uvmaero/CleanSpeed_6.0_Board/Documentation/Working in the packs.pdf

## Standard Operating Procedure TEMPLATE

This template is to be adapted to particular processes for individual labs. A specific SOP may need more sections than what is listed below. Once completed, a copy should be kept in the lab safety notebook with documentation that researchers have reviewed and will comply with the completed document.

Laboratory Supervisor (PI): | Date: 10/13/23
Building: Votey | Room(s): 118

## Section 1: Process and Composition

Basic explanation of the process (e.g. work with HF, working in a glove box, etc.) AND composition of the solution (e.g. aqua regia, piranha solution, etc.) Work with High Voltage, Working with accumulators off the Car

## Section 2: Potential Hazards

Describe the hazards and how they can harm researchers. High voltage, Shock and arch flash

## Section 3: Engineering Controls

Describe where the work will be done in the lab. e.g. fume hood, glove box, biosafety cabinet, specific lab bench, etc. On an isolated work bench

## Section 4: Special Handling Procedures

Describe any particular handling procedures that should be followed. Removal of all jewlery Not wearing any thing dangling ie hoodie strings rolled up sleeves

## Section 5: Personal Protective Equipment (PPE)

Describe the PPE that should be worn, including the material, thickness, and other particulars. High Voltage Gloves (leather protectors, isolation layer, cloth), Arch face sheild,

## Section 6: Storage Requirements

Describe any requirements based on the process or solution(s) being used. Include primary and secondary containers, cabinets, etc. The batteries must be stored in fire proof container (typically withing the accumulator boxes) When work is complete they must be stored such that a tool is needed to open gain access to the high voltage. If storage under tool is not possible the area must be well labeled that high voltage is pressent and no exposed high voltage may be pressent. the use of high voltage blankets may be required.

## Section 7: Spill and Accident Procedures

First Aid measures:
Inhalation:
Ingestion:
Skin absorption:
Eye exposure:
Chemical (or Biological or Radioactive) Spill measures:

## Section 8: Waste Disposal

Describe how to handle and dispose of waste generated during the process or simply the solution. Include labeling for storage of waste and tagging for waste pick up. Waste will only be produced when a cell has gone bad. To dispose of the cell it must be discharged to 2.5V via a resistor bank then work with the lab suporvisor as to the propper disposal for the volume of cells.

## Section 9: Decontamination

If decontamination will be needed (of glassware, work area, etc.), detail what will be used to perform the decontamination and the process of completing this task.

## Section 10: Training

All personnel are required to complete the general online and classroom safety training courses. Any personnel must review the guidelines here before work commences. Any appropriate Lab Risk Assessments or Chemical Use and Planning Forms must be reviewed as well.
If there are particular training requirements for the lab, include them here. In Person High voltage AERO training: Training includes: 1) A lesson in the dangers of high voltage 2) Learning how to propperly Don all PPE 3) Dexterity training and testing away from high voltage to get used to the PPE 4) Simulating the high Voltage work at smaller scale 5) Demonstraiting knowledge of high voltage and the previous procedures 6) Doinng monitored high voltage work

## Section 11: Specific Procedure Description

In DETAIL, describe the procedure for either doing the work or making the solution mentioned in Section 1. Specific amounts of reagents should be included where appropriate. This can be a step-by-step guide. 1) Have the accumulator(s) placed on the green high voltage cart 2) Ensure someone is in charge of the "pokey stick" who will monitor all high voltage work 4) Have the RSO check the area is secure and there is proper egress 5) Turn the SMD to the "off" position and have the RSO or a leader fill out the "Lock Out Tag Out" form. 6) Once deemed "safe" and locked out, the container can be opened using non-isolated tools 7) Once the pack is open, high voltage PPE must be donned and whatever work that needs to be done on the packs can be carried out using isolated tools. 8) Once work is complete, the packs must be secured using a tool (e.g. bolted down) so the packs are safe. 9) If unable to close the packs, they must be covered with high voltage blankets and whoever is doing the work must provide contact information as well as the RSO information and signage indicating high voltage is present 10) Unless the packs are going to be placed on the car, the SMD shall remain locked until they go into service.

## Section 12: “What-If” Analysis

In DETAIL, examine any foreseeable incidents to help prevent accidents and injuries from occurring. Fire: small fire: If possible and safe isolate the cell from the packs and place it within a lipo pouch. Once in the lipo pouch place the pouch outside on the concrete slab to the left of the doors across from the shop. Report the incident to the RSO and the lab supervisor. large fire: If there is a fire within the accumulator that cannot be mitigated safley there are a few options for action. If the fire is small but cannot be removed from accumulator, safely move the accumulator out of the building on the High Voltage cart. Contact the RSO, lab supervisor and uvm police. If the fire is not safe to be around, evacuate the club space and votey. The quickest way to do this is via any of the pull fire alarms. Contact 911 and inform the lab suporvisor. Remain near votey so that you can be the point of contact for the first responders who arrive.

## Section 13: Signature(s) of Compliance

I have read and fully understand the above SOP. I will adhere to all stated regulations and safety measures when using this chemical. Colin Grund

__________________________________ | _______________________________________
Name (Print) | Signature and Date
__________________________________ | _______________________________________
Name (Print) | Signature and Date
__________________________________ | _______________________________________
Name (Print) | Signature and Date
__________________________________ | _______________________________________
Name (Print) | Signature and Date
__________________________________ | _______________________________________
Name (Print) | Signature and Date
__________________________________ | _______________________________________
Name (Print) | Signature and Date
__________________________________ | _______________________________________
Name (Print) | Signature and Date
__________________________________ | _______________________________________
Name (Print) | Signature and Date
__________________________________ | _______________________________________
Name (Print) | Signature and Date
__________________________________ | _______________________________________
Name (Print) | Signature and Date
