uvmaero/CleanSpeed_6.0_Board/Big Daddy/bom/2024-02-14T124227.xlsx

Index | Quantity | Part Number | Manufacturer Part Number | Description | Customer Reference | Available | Backorder | Unit Price | Extended Price USD
1 | 4 | 20J15KE-ND | 20J15KE | RES 15K OHM 5% 10W AXIAL |  | 4 | 0 | 3.99 | 15.96
2 | 10 | RMCF2512FT1R00CT-ND | RMCF2512FT1R00 | RES 1 OHM 1% 1W 2512 |  | 10 | 0 | 0.148 | 1.48
3 | 5 | 160-1367-5-ND | LTV-817S | OPTOISOLATR 5KV TRANSISTOR 4-SMD |  | 5 | 0 | 0.44 | 2.20
4 | 5 | PPC39KW-1CT-ND | PR01000103902JR500 | RES 39K OHM 1W 5% AXIAL |  | 5 | 0 | 0.27 | 1.35
5 | 5 | 408-1947-1-ND | HRG3216P-1000-B-T1 | RES SMD 100 OHM 0.1% 1W 1206 |  | 5 | 0 | 1.18 | 5.90
6 | 5 | RL12S.20FCT-ND | RL1220S-R20-F | RES 0.2 OHM 1% 1/3W 0805 |  | 5 | 0 | 0.3 | 1.50
7 | 10 | 4878-1N4148WCT-ND | 1N4148W | DIODE GEN PURP 75V 150MA SOD123F |  | 10 | 0 | 0.07 | 0.70
8 | 10 | 1801-SS16CT-ND | SS16 | DIODE SCHOTTKY 60V 1A DO214AC |  | 10 | 0 | 0.252 | 2.52
9 | 10 | DESD2CAN2SOQ-7DICT-ND | DESD2CAN2SOQ-7 | TVS DIODE 24VWM 41VC SOT23 |  | 10 | 0 | 0.336 | 3.36
10 | 10 | 1801-TS4148RCGCT-ND | TS4148 RCG | DIODE GEN PURP 75V 100MA 0603 |  | 10 | 0 | 0.137 | 1.37
11 | 10 | 160-1367-5-ND | LTV-817S | OPTOISOLATR 5KV TRANSISTOR 4-SMD |  | 10 | 0 | 0.269 | 2.69
12 | 10 | 296-46427-1-ND | LM5050MKX-1/NOPB | IC OR CTRLR N+1 6SOT |  | 10 | 0 | 1.847 | 18.47
13 | 2 | LT1528CQ#PBF-ND | LT1528CQ#PBF | IC REG LIN POS ADJ 3A 5DDPAK |  | 2 | 0 | 11.61 | 23.22
14 | 5 | ICM7555ISA+-ND | ICM7555ISA+ | IC OSC SGL TIMER 500KHZ 8-SOIC |  | 5 | 0 | 4.12 | 20.60
15 | 5 | 2521-IS31LT3360-SDLS3-TRCT-ND | IS31LT3360-SDLS3-TR | IC LED DRV RGLTR PWM SOT89-5 |  | 5 | 0 | 0.87 | 4.35
16 | 5 | TLP184(BL-TPLSECT-ND | TLP184(BL-TPL,SE | OPTOISO 3.75KV TRANS 6-SO 4 LEAD |  | 5 | 0 | 0.5 | 2.50
17 | 5 | LM317D2TR4GOSCT-ND | LM317D2TR4G | IC REG LIN POS ADJ 1.5A D2PAK-3 |  | 5 | 0 | 0.83 | 4.15
18 | 5 | Z768-ND | G5V-2-DC12 | RELAY GEN PURPOSE DPDT 2A 12V |  | 5 | 0 | 3.21 | 16.05
19 | 4 | IXFH34N65X2-ND | IXFH34N65X2 | MOSFET N-CH 650V 34A TO247 |  | 4 | 0 | 8.16 | 32.64
20 | 2 | PB2352-ND | T9VV1K15-12S | RELAY GEN PURPOSE SPST 40A 12V |  | 2 | 0 | 7.73 | 15.46
21 | 3 | 2449-J107F1CS123VDC.36-ND | J107F1CS123VDC.36 | RELAY GEN PURPOSE SPDT 12A 3V |  | 3 | 0 | 1.04 | 3.12
22 | 2 | Z2204-ND | G5V-1-DC3 | RELAY GENERAL PURPOSE SPDT 1A 3V |  | 2 | 0 | 2.22 | 4.44
23 | 5 | 2N7002NCT-ND | 2N7002 | MOSFET N-CH 60V 115MA SOT-23 | 5 | 5 | 0 | 0.45 | 2.25
24 | 5 | BCP53T1GOSCT-ND | BCP53T1G | TRANS PNP 80V 1.5A SOT223 |  | 5 | 0 | 0.4 | 2.00
25 | 5 | MMBT2222LT1GOSCT-ND | MMBT2222LT1G | TRANS NPN 30V 0.6A SOT23-3 |  | 5 | 0 | 0.15 | 0.75
