uvmaero/CleanSpeed_6.0_Board/BMS1/Jumper/production/Jumper_2024-02-16_11-31-33/bom.csv

Designator | Footprint | Quantity | Value | LCSC Part #
Jumper | LTC6812 | 1 | LTC6812
U2 | QFP-64_11x11_Pitch0.5mm | 1 | LTC6812-1
