uvmaero/CleanSpeed_6.0_Board/Documentation/connectors.xlsx

Index | Quantity | Part Number | Manufacturer Part Number | Description | Customer Reference | Available | Backorder | Unit Price | Extended Price USD
1 | 2 | 1873-2108-12S-ND | 2108-12S | CONFORMAL COATING ACRYLIC |  | 2 | 0 | 30.5 | 61.00
2 | 3 | 965-SLPPA25BSB1-ND | SLPPA25BSB1 | SURLOK PLUS |  | 3 | 0 | 12.11 | 36.33
3 | 3 | 965-SLPPA25BSR0-ND | SLPPA25BSR0 | SURLOK PLUS |  | 3 | 0 | 13.23 | 39.69
4 | 4 | 965-SLPIRABPSR0-ND | SLPIRABPSR0 | SURLOK PLUS |  | 4 | 0 | 11.11 | 44.44
5 | 4 | 965-SLPIRABPSB1-ND | SLPIRABPSB1 | SURLOK PLUS |  | 4 | 0 | 11.11 | 44.44
6 | 2 | 965-SLPIPA25BSB1-ND | SLPIPA25BSB1 | SURLOK PLUS, STRAIGHT PLUG, 5.7M | 2 | 2 | 0 | 14.42 | 28.84
7 | 2 | 965-SLPIPA25BSR0-ND | SLPIPA25BSR0 | SURLOK PLUS, STRAIGHT PLUG, 5.7M |  | 2 | 0 | 14.42 | 28.84
