uvmaero/CleanSpeed_6.0_Board/BMS1/Jumper/slpirabpsr4-c3d.STP

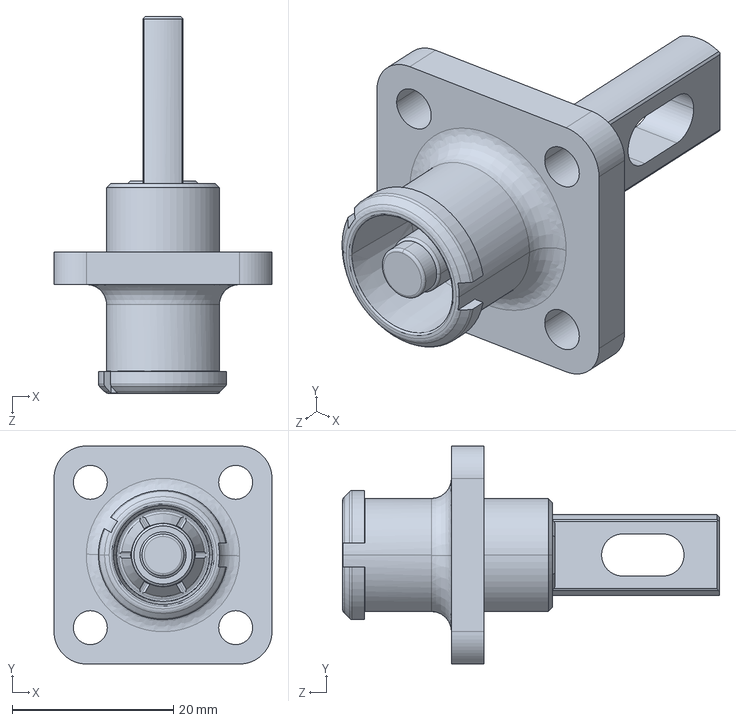
[picture p8: CAD file, 2024-05-02]
BMS1/Jumper/slpirabpsr4-c3d.STP
27.0 x 27.0 x 46.7 mm
