uvmaero/CleanSpeed_6.0_Board/BMS1/Print Schematic.pdf

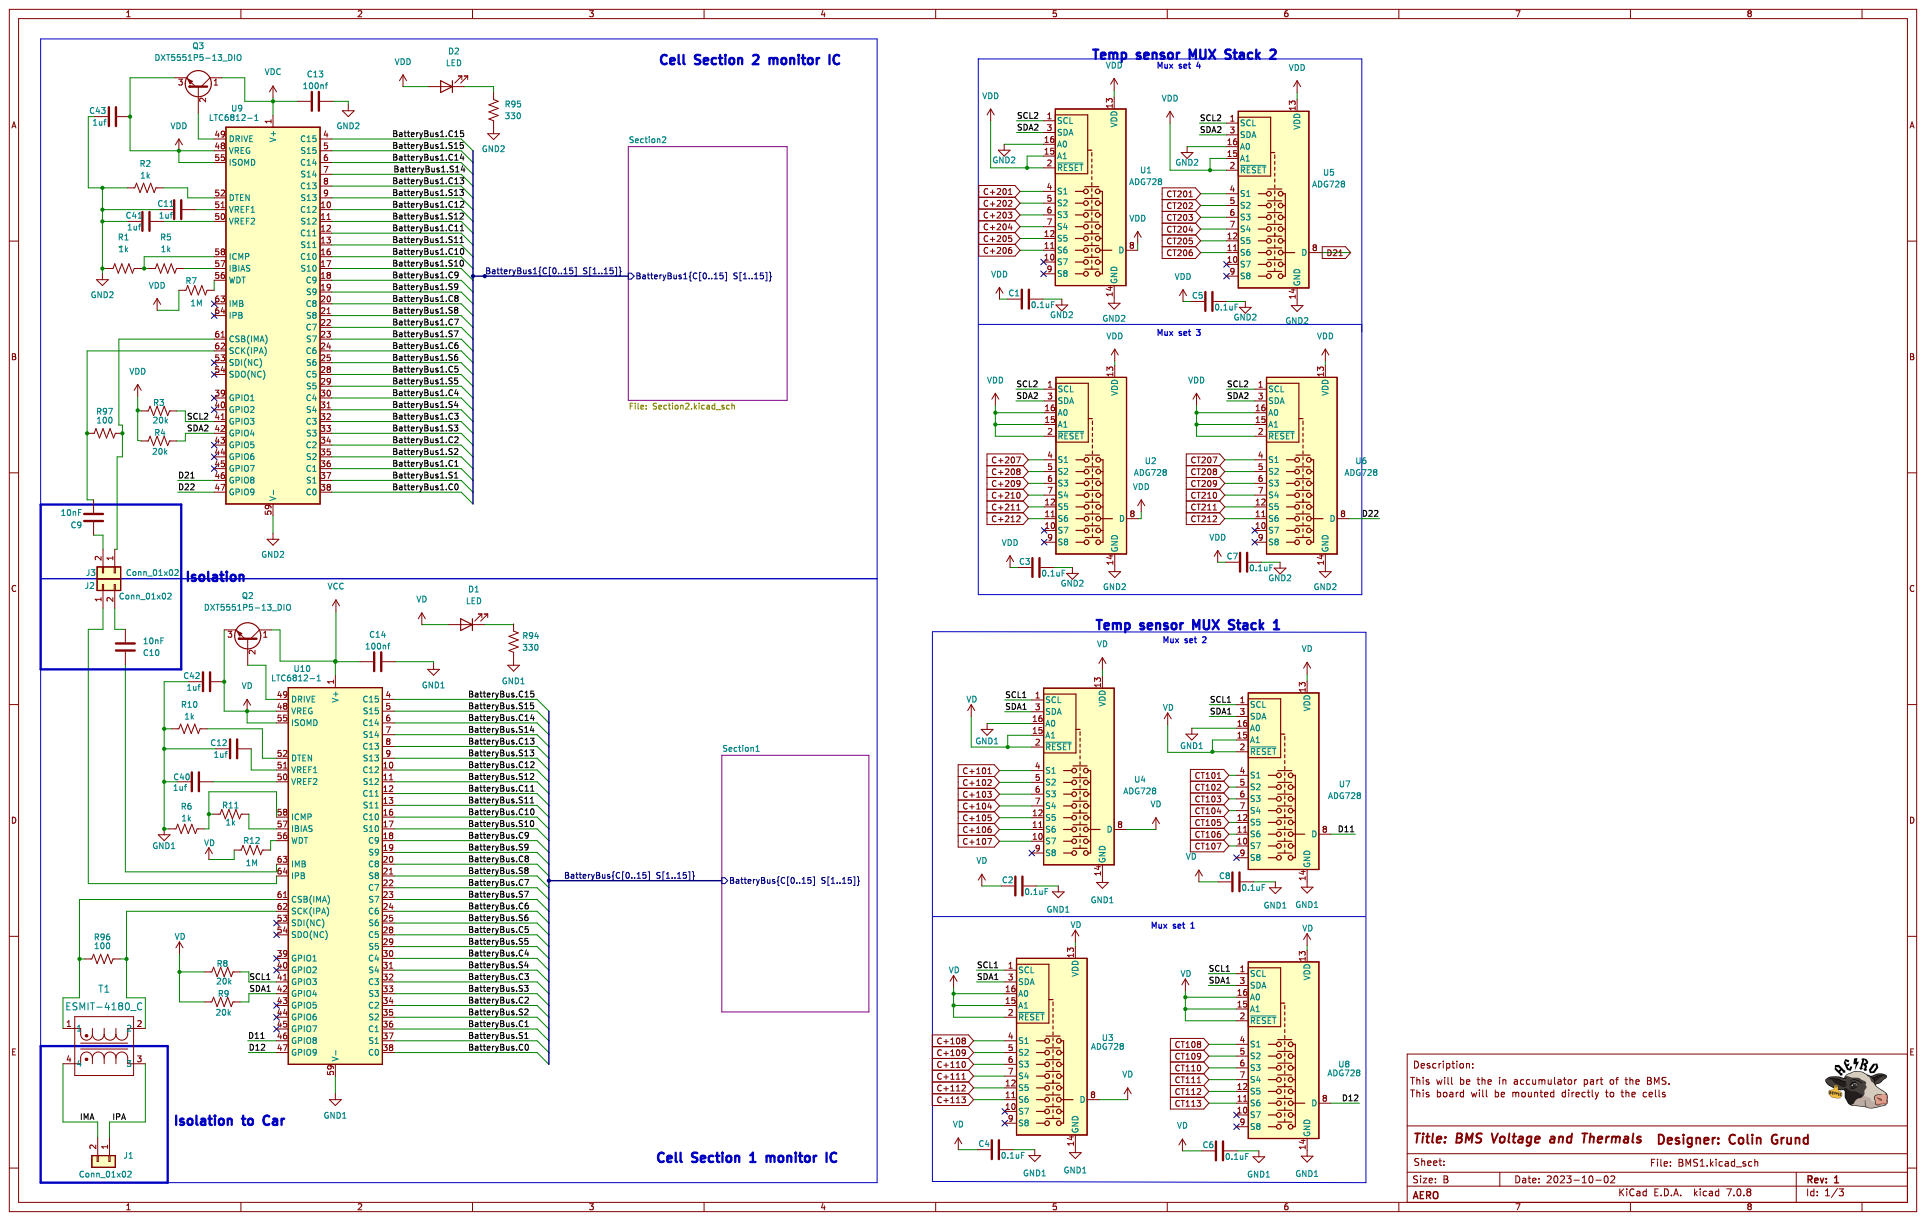
[picture p10: page 1]

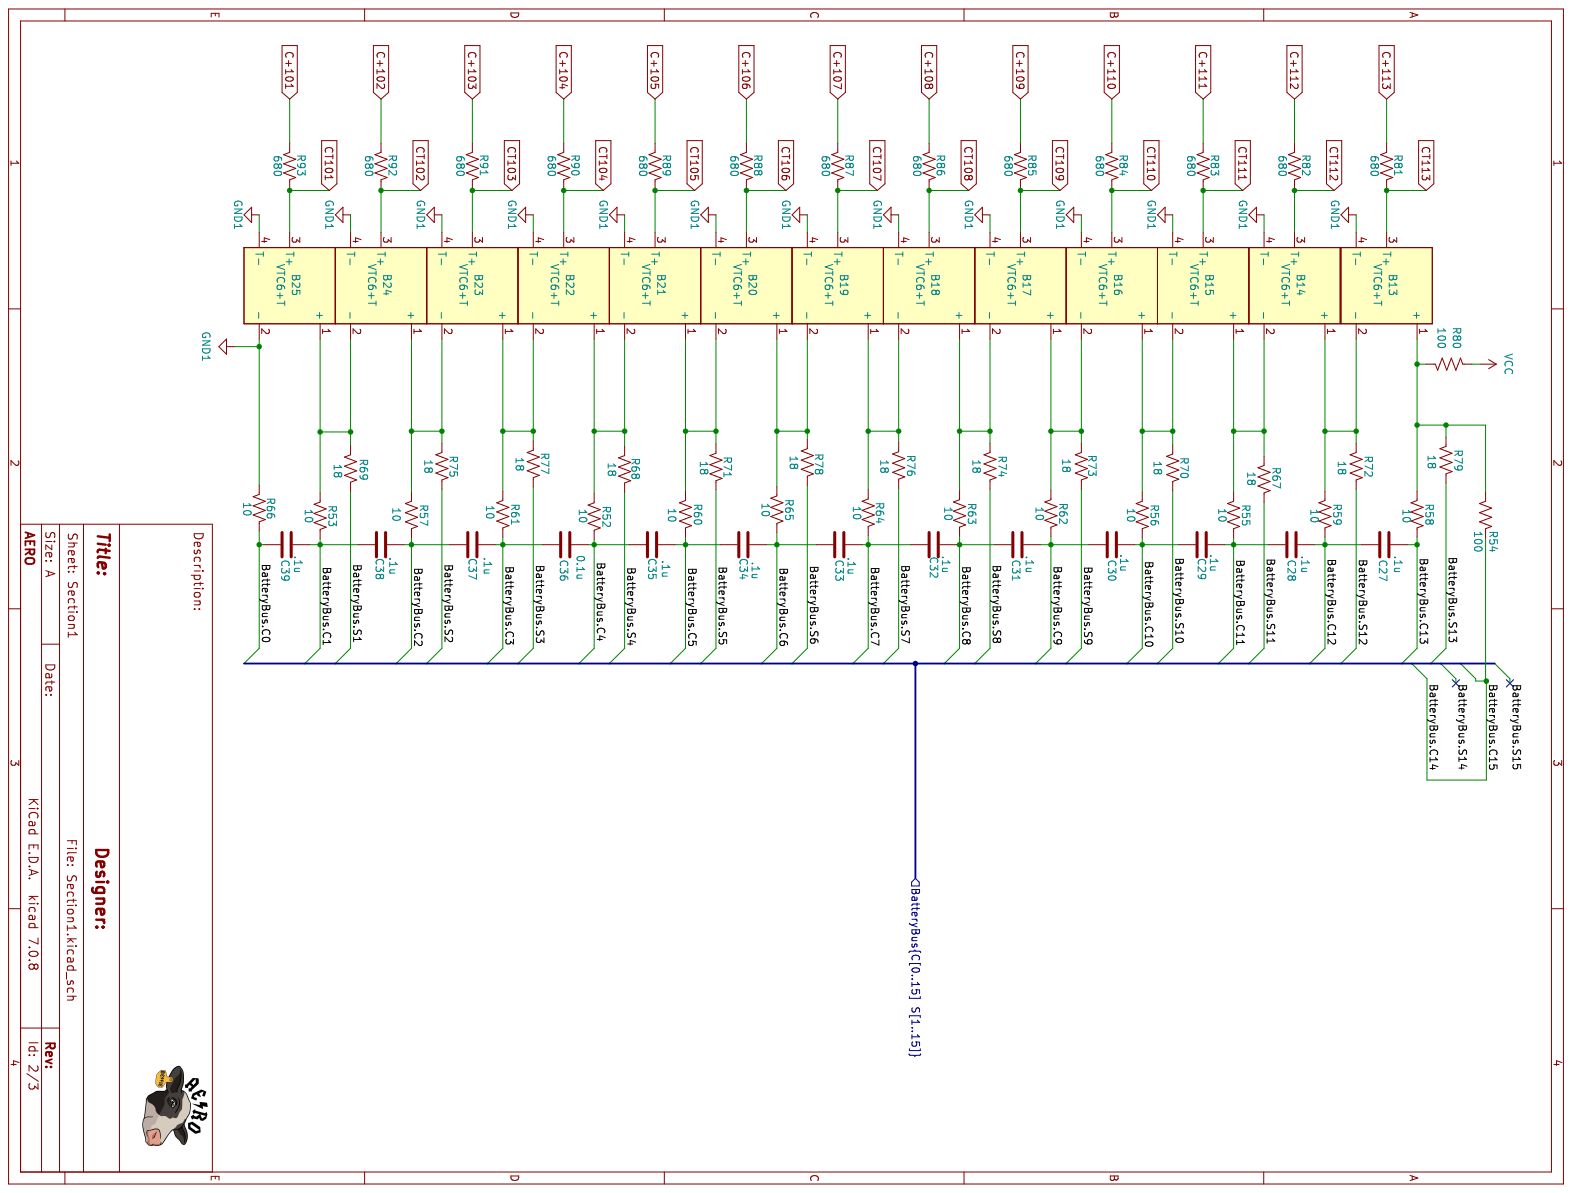
[picture p11: page 2]

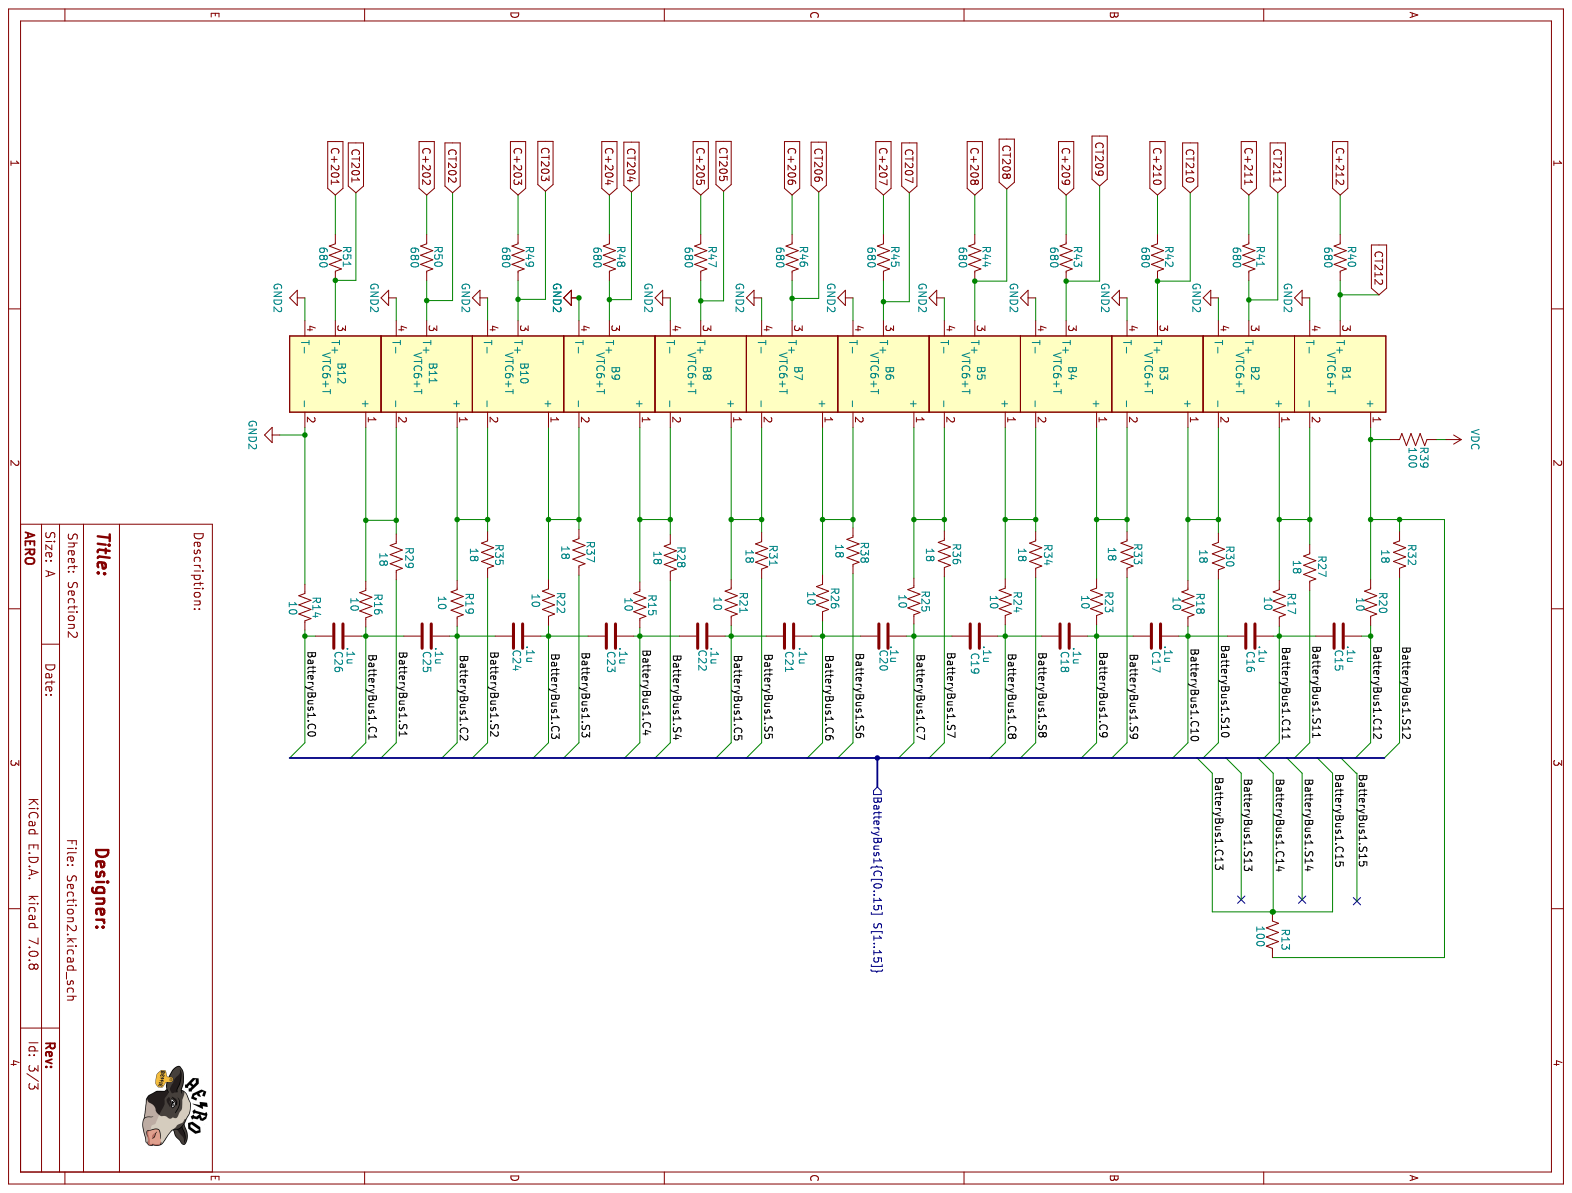
[picture p12: page 3]
