uvmaero/CleanSpeed_6.0_Board/BMS1/Print Schematic2.pdf

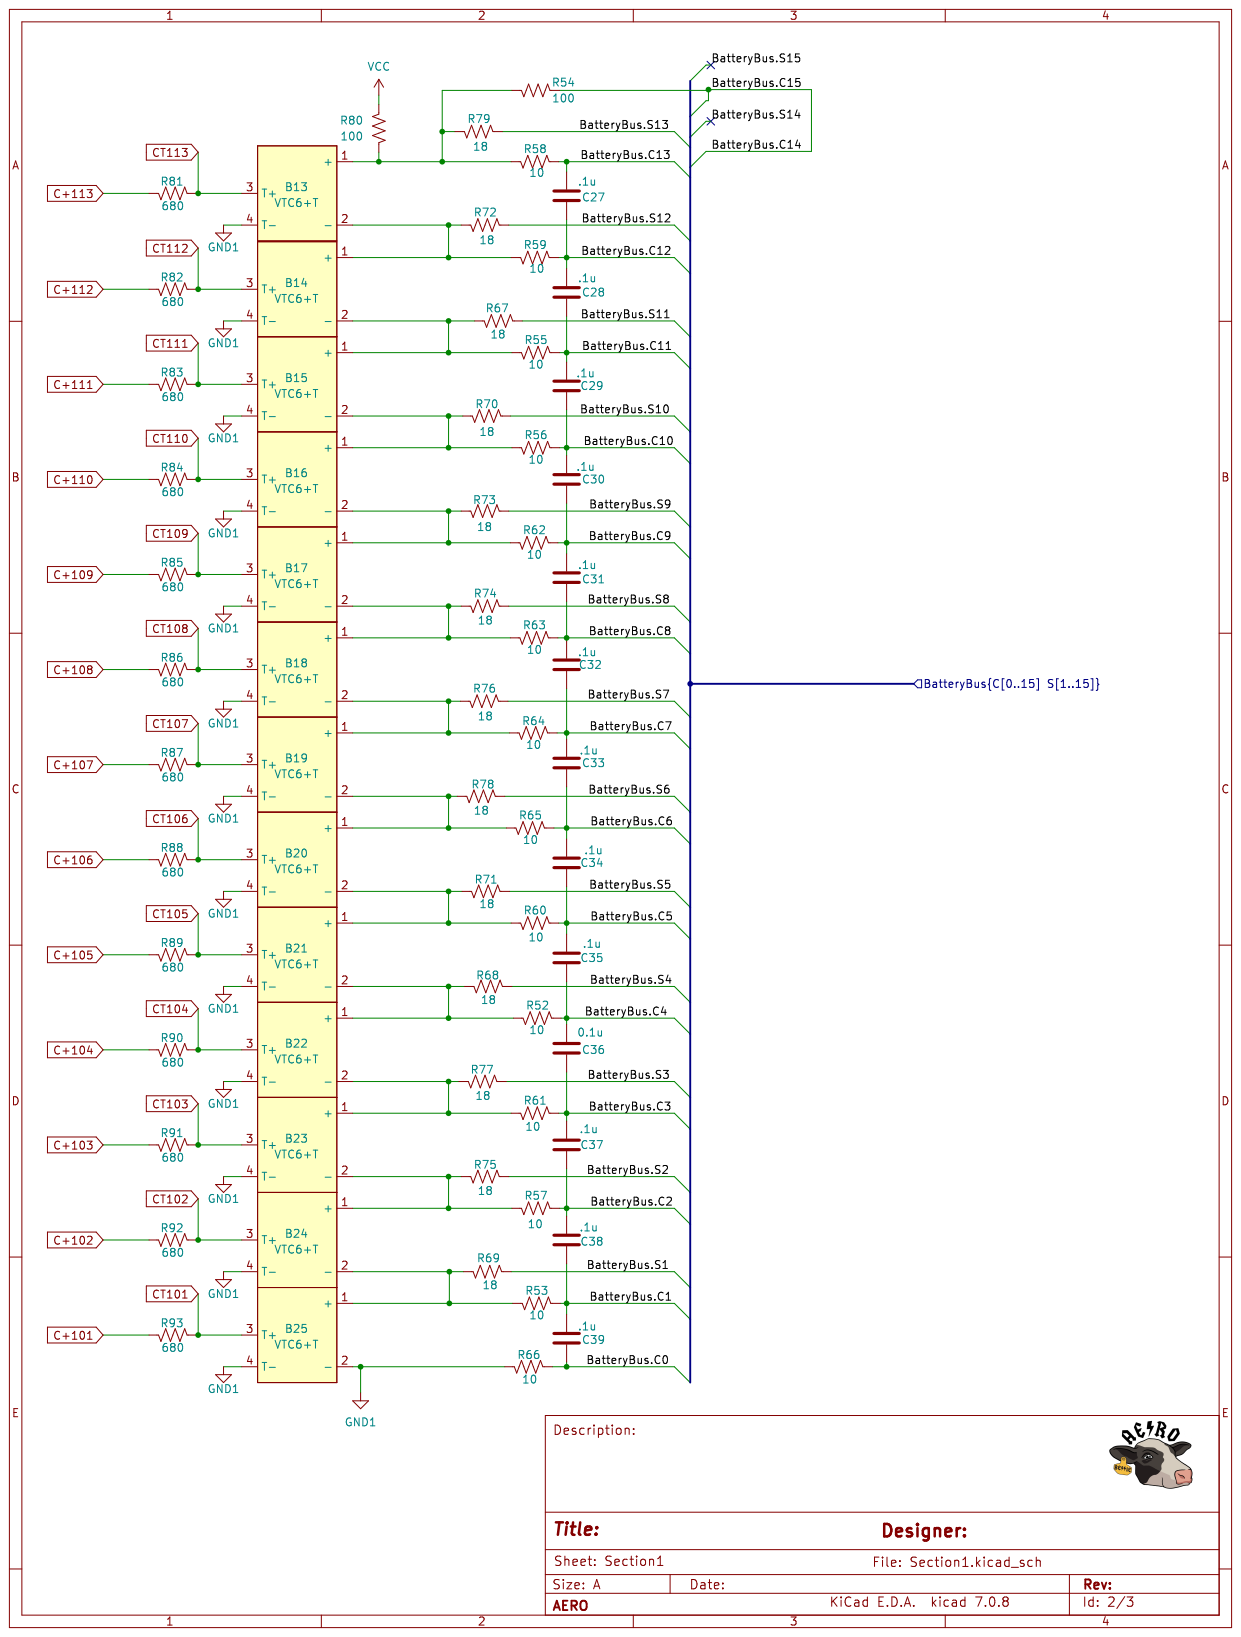
[picture p13: page 1]
