uvmaero/CleanSpeed_6.0_Board/BMS1/Print Schematic3.pdf

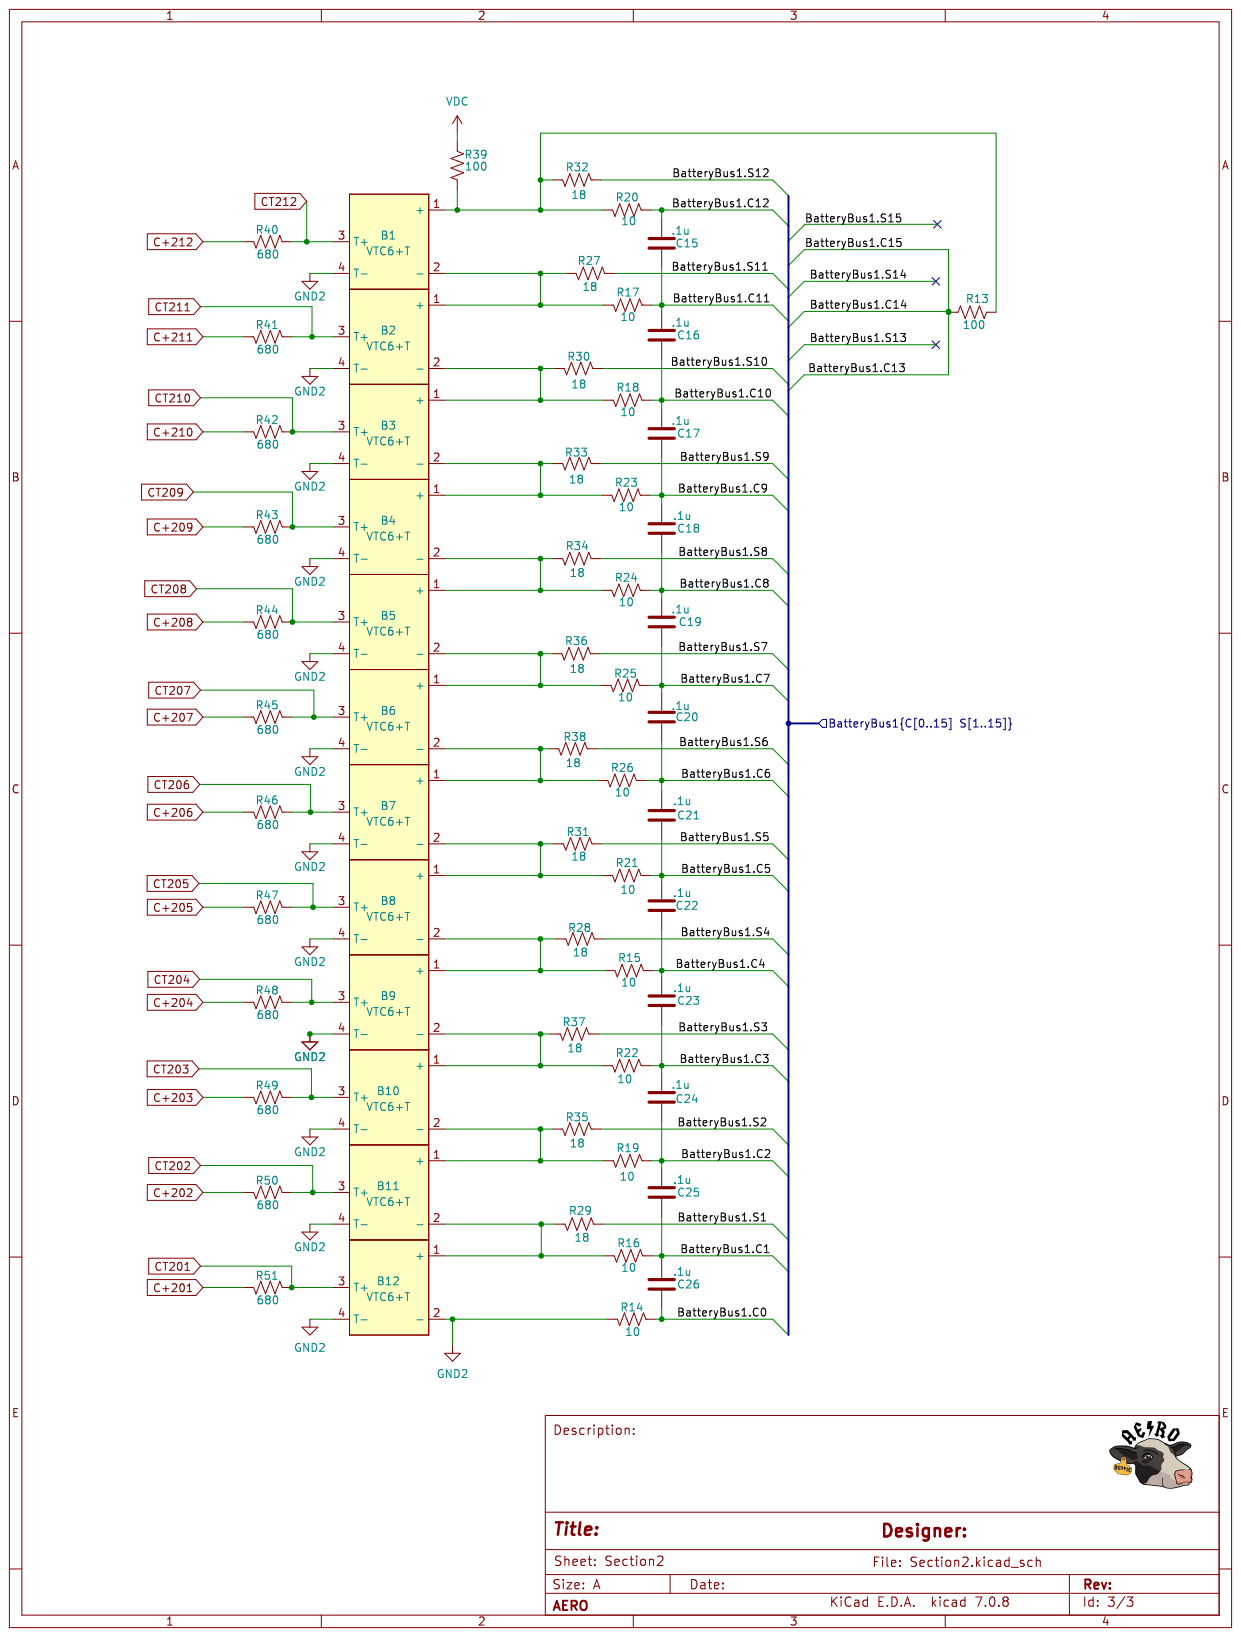
[picture p14: page 1]
