uvmaero/CleanSpeed_6.0_Board/Big Daddy/Schematic main.pdf

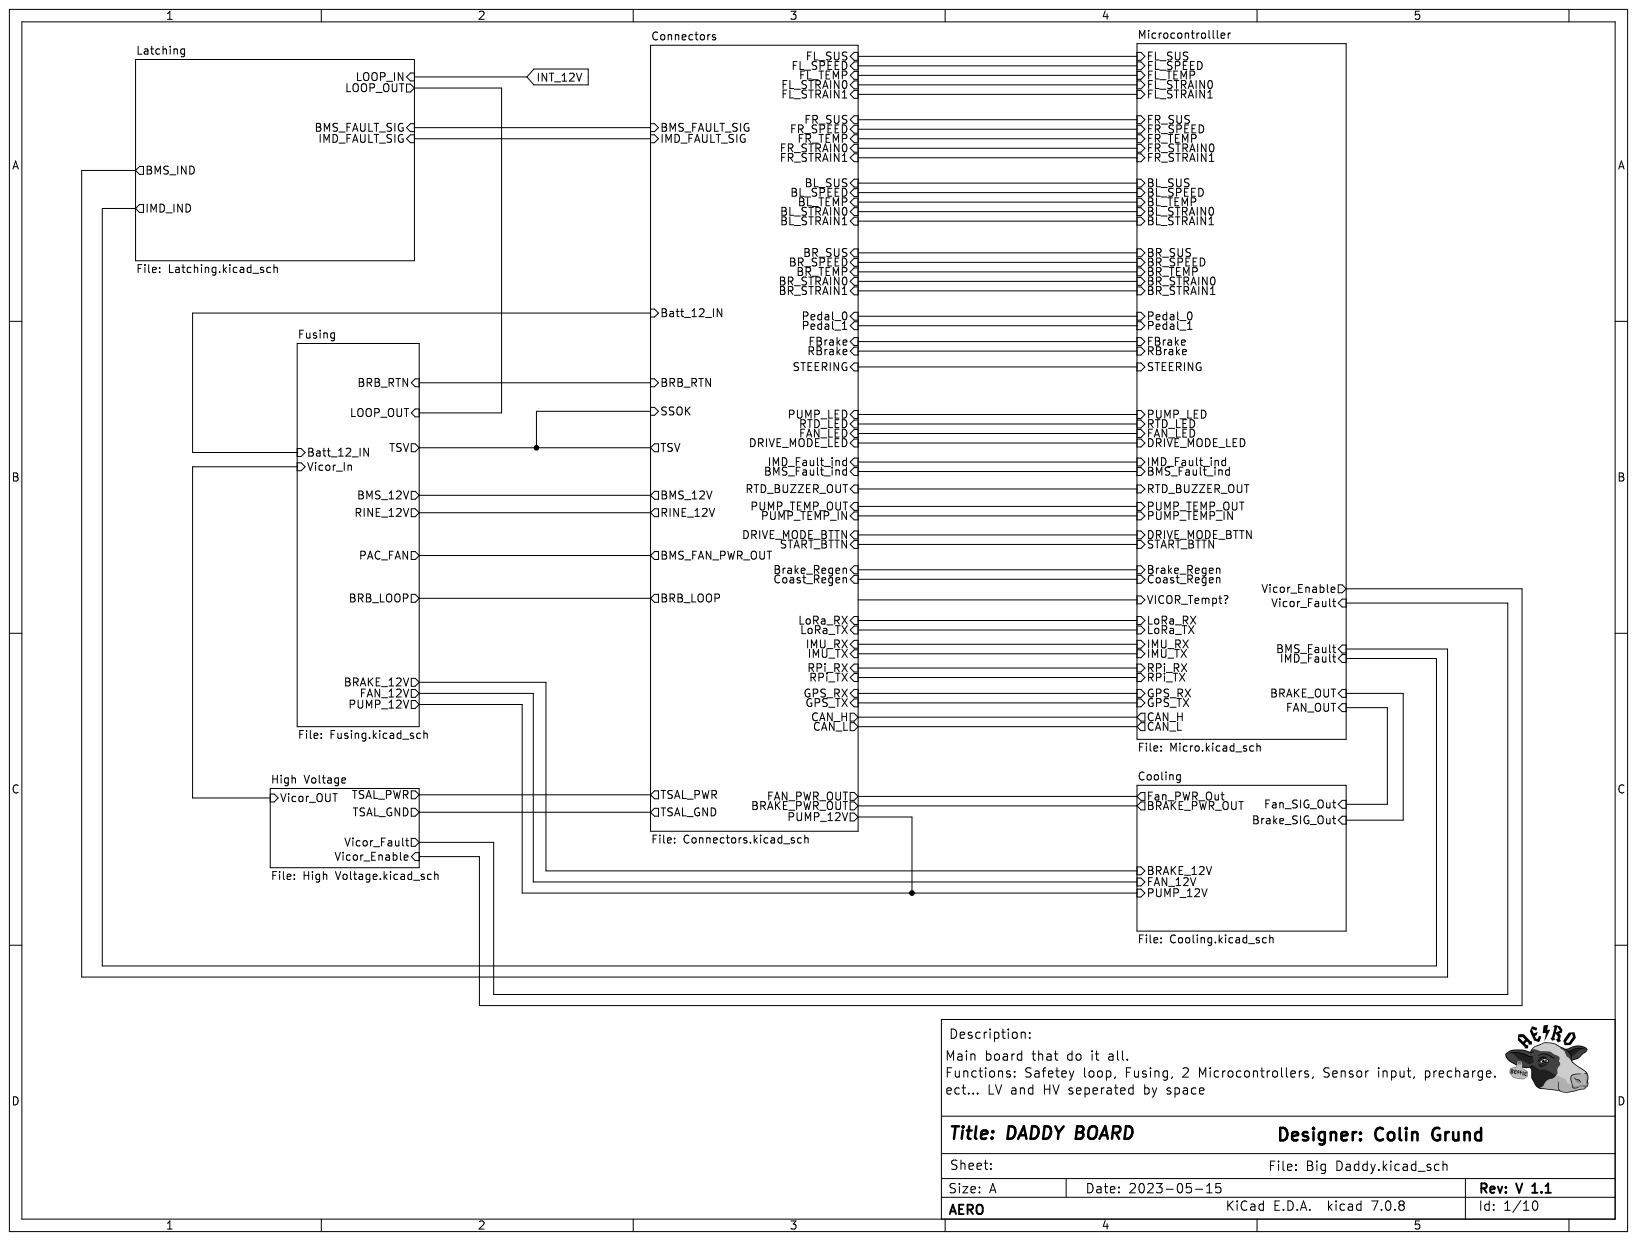
[picture p15: page 1]

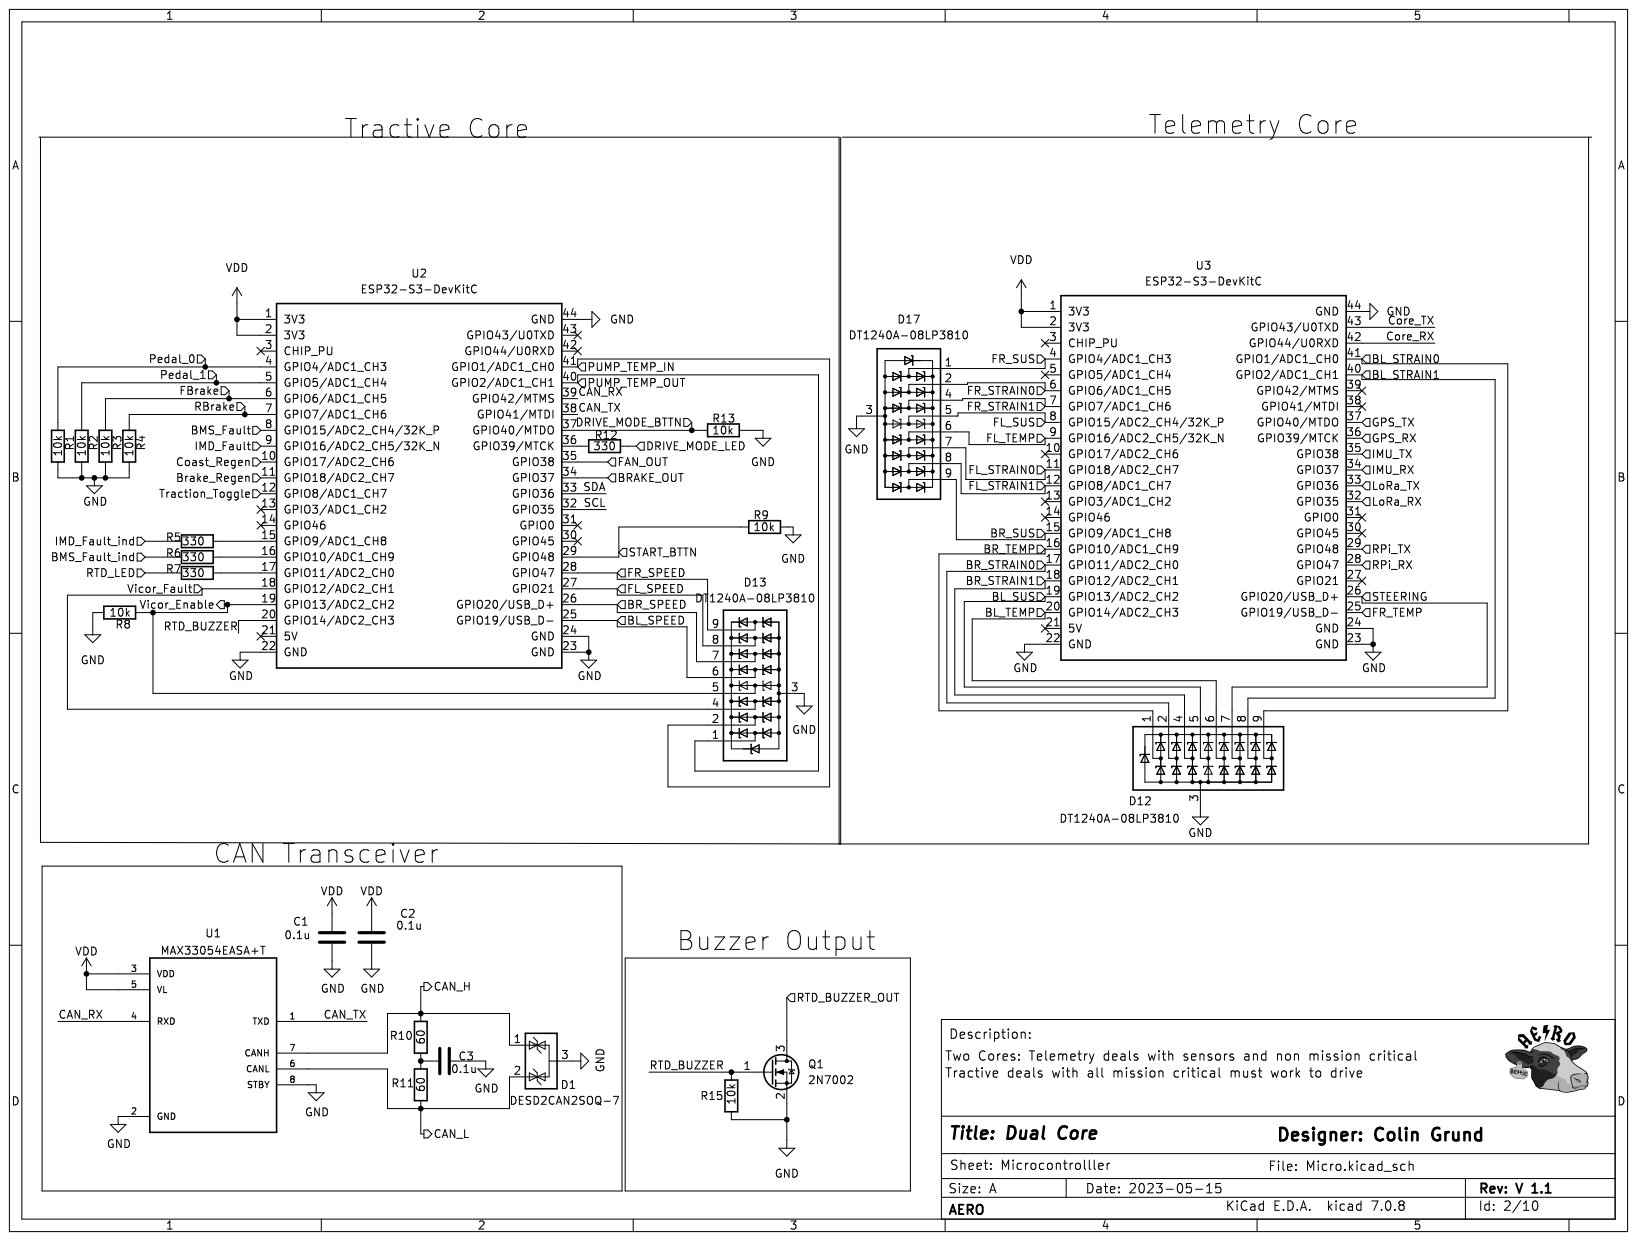
[picture p16: page 2]

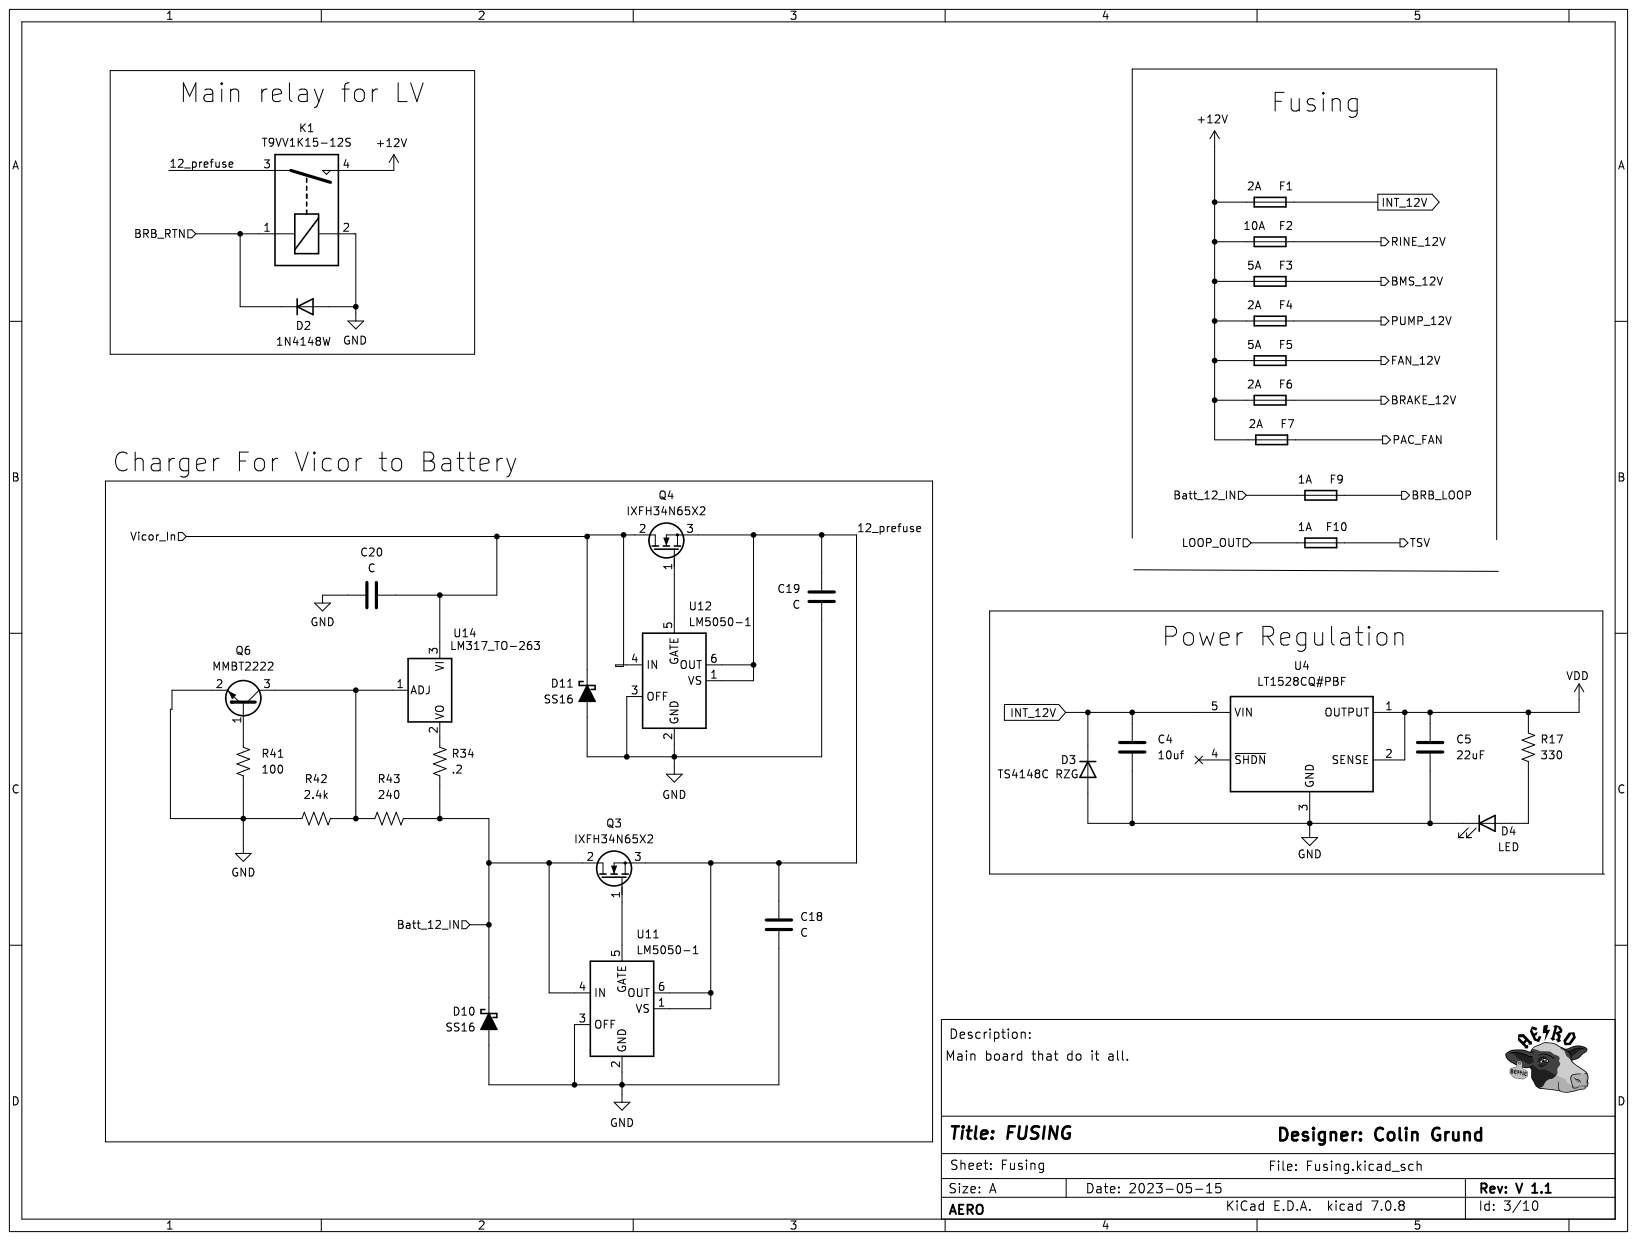
[picture p17: page 3]

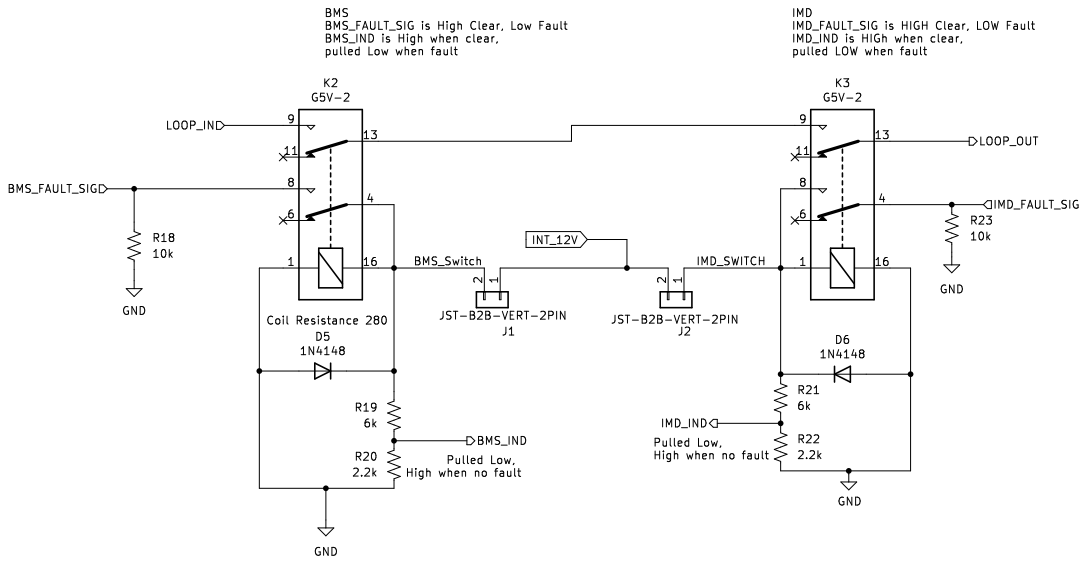
[picture p18: page 4]

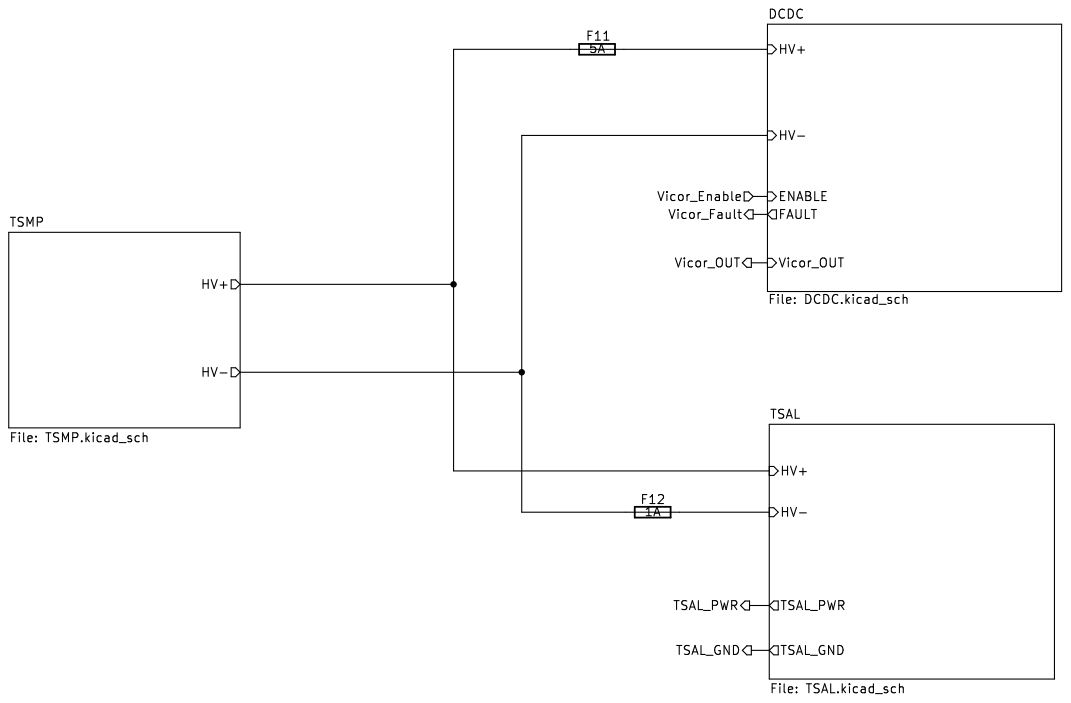
[picture p19: page 5]

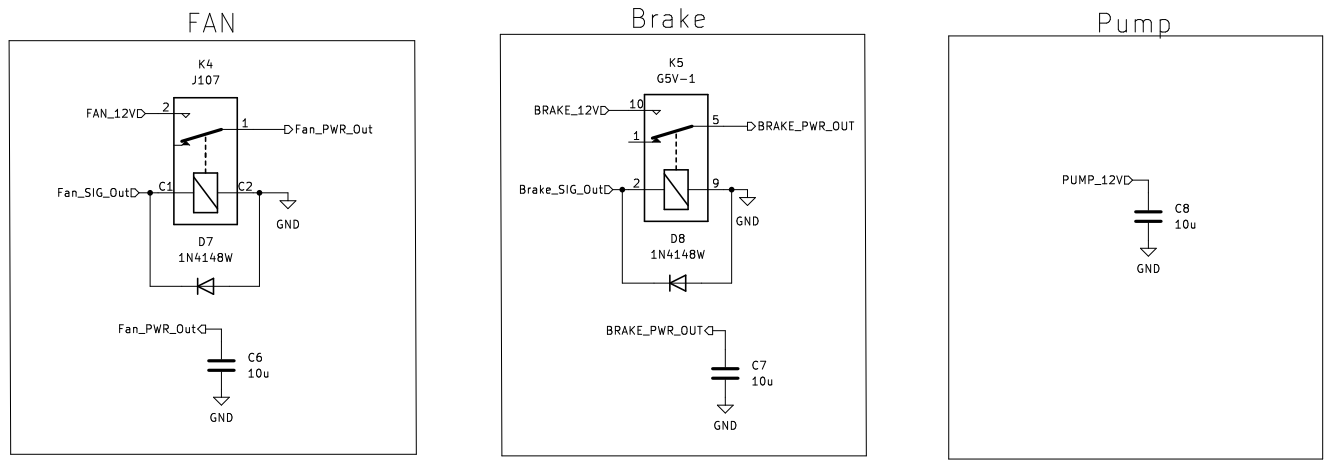
[picture p20: page 6]

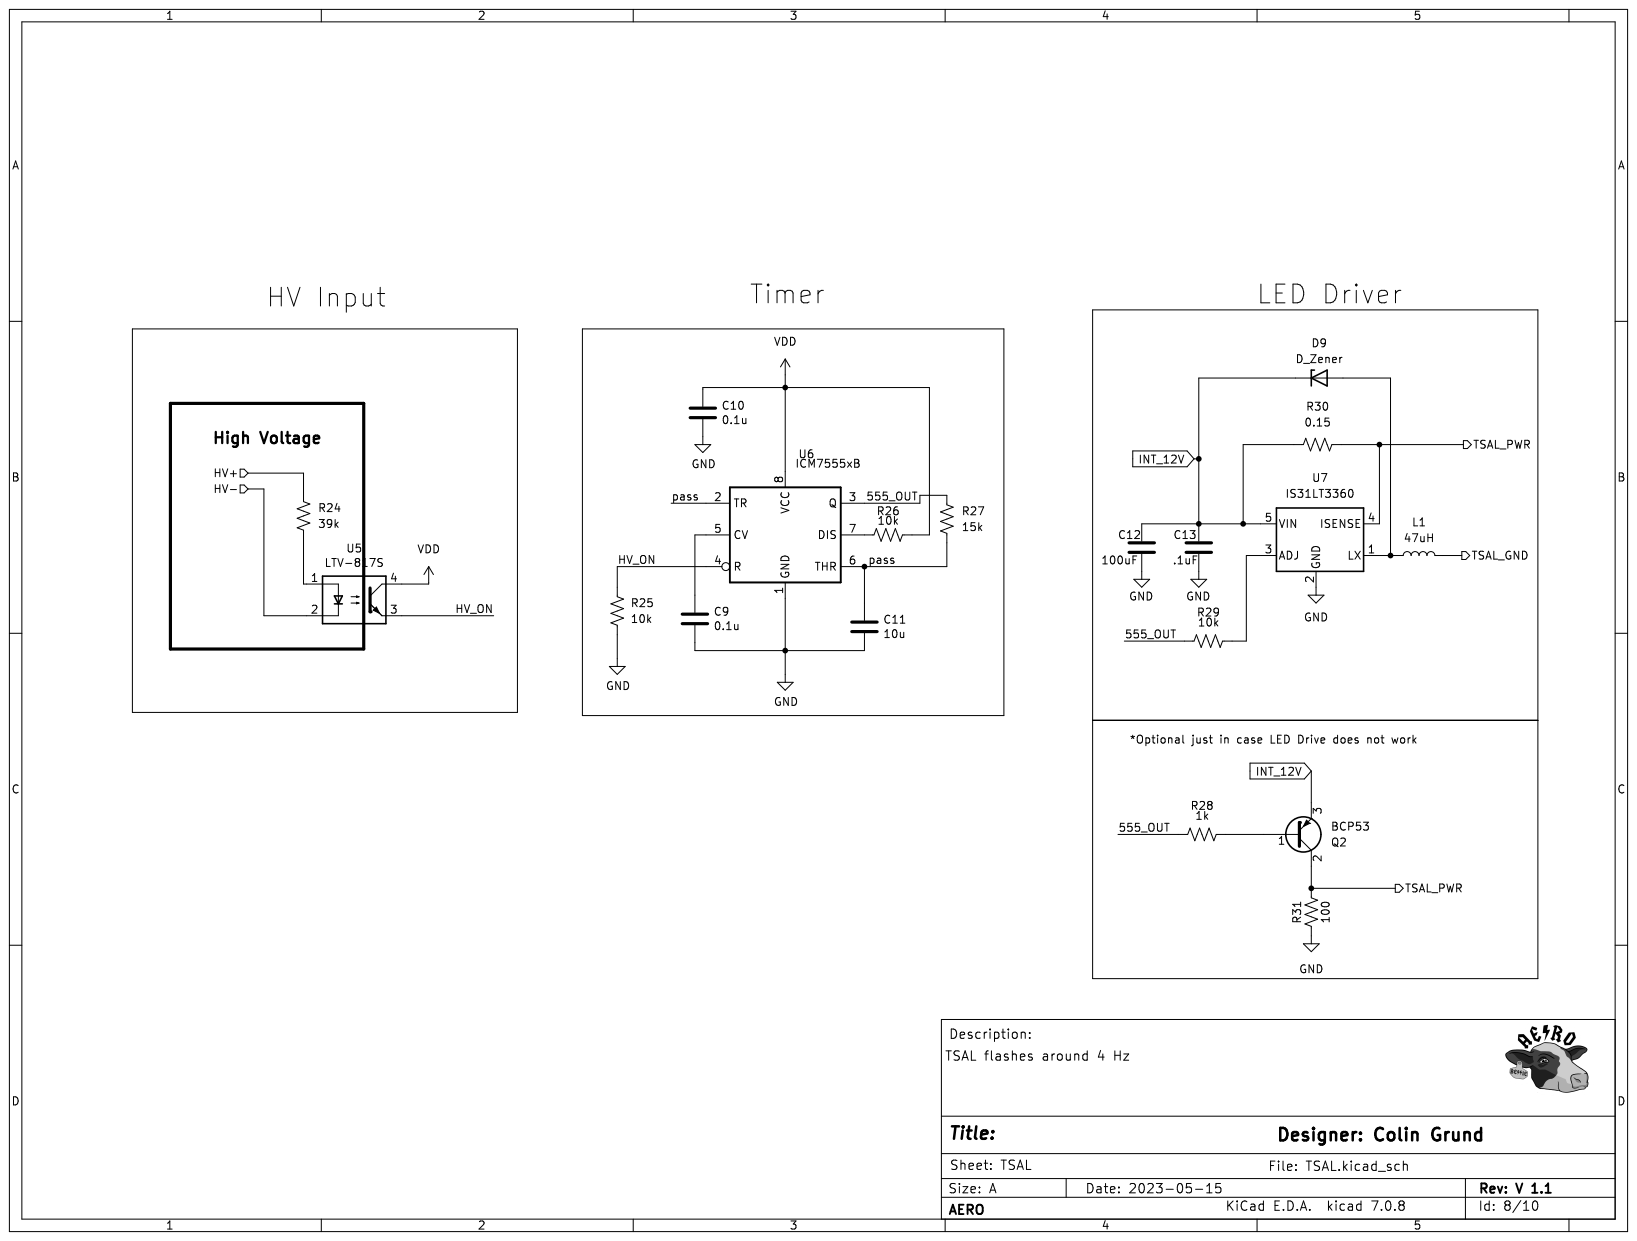
[picture p21: page 7]

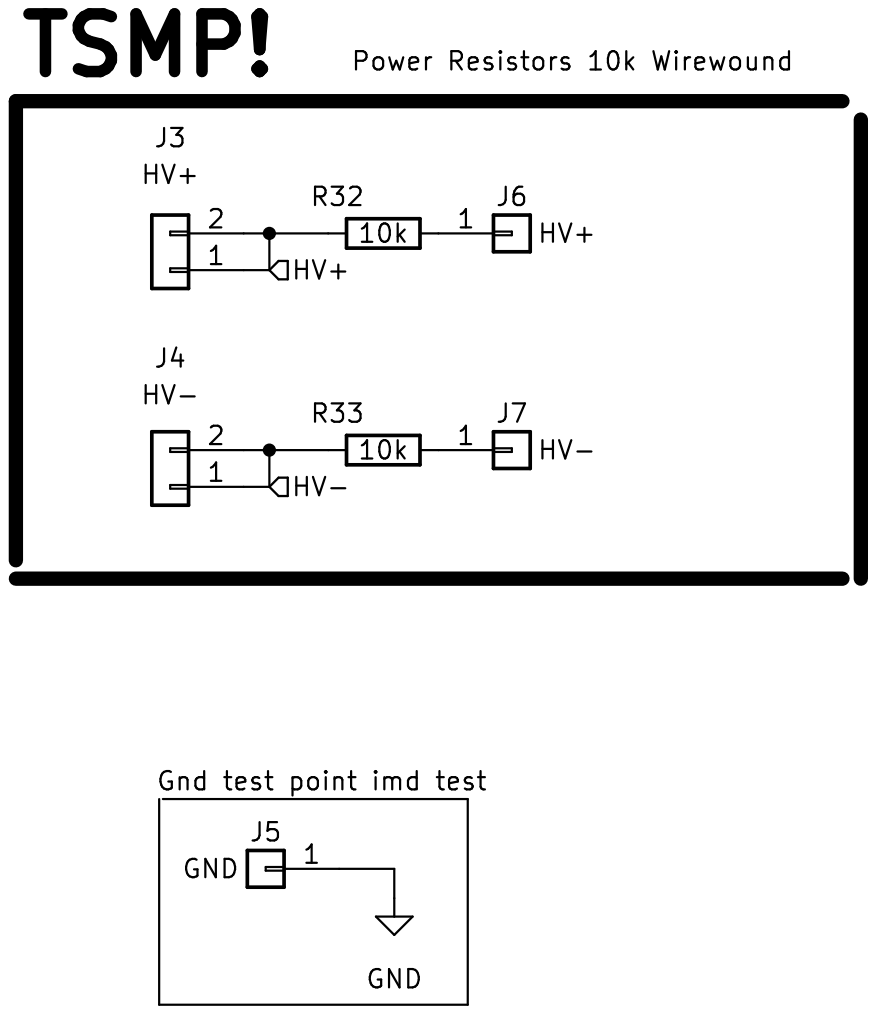
[picture p22: page 8]

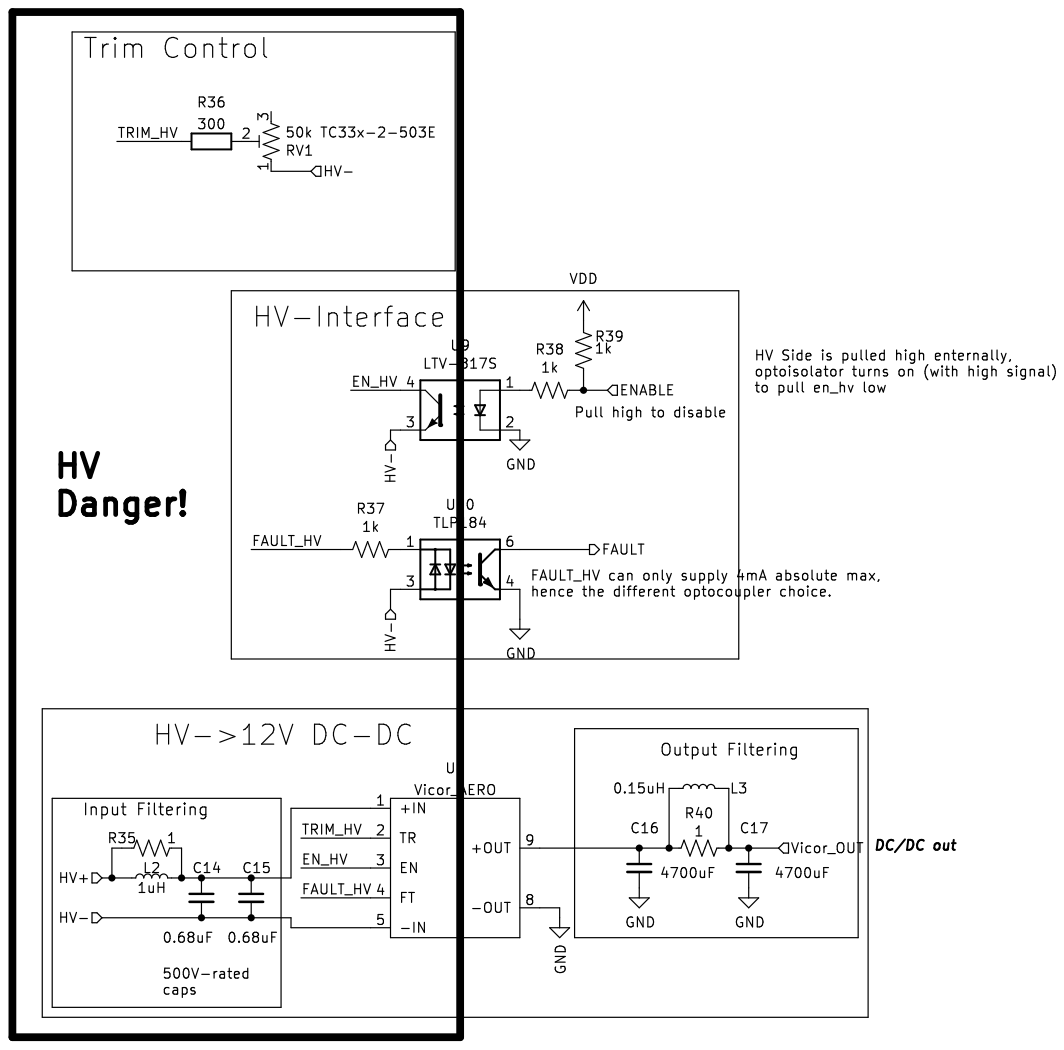
[picture p23: page 9]

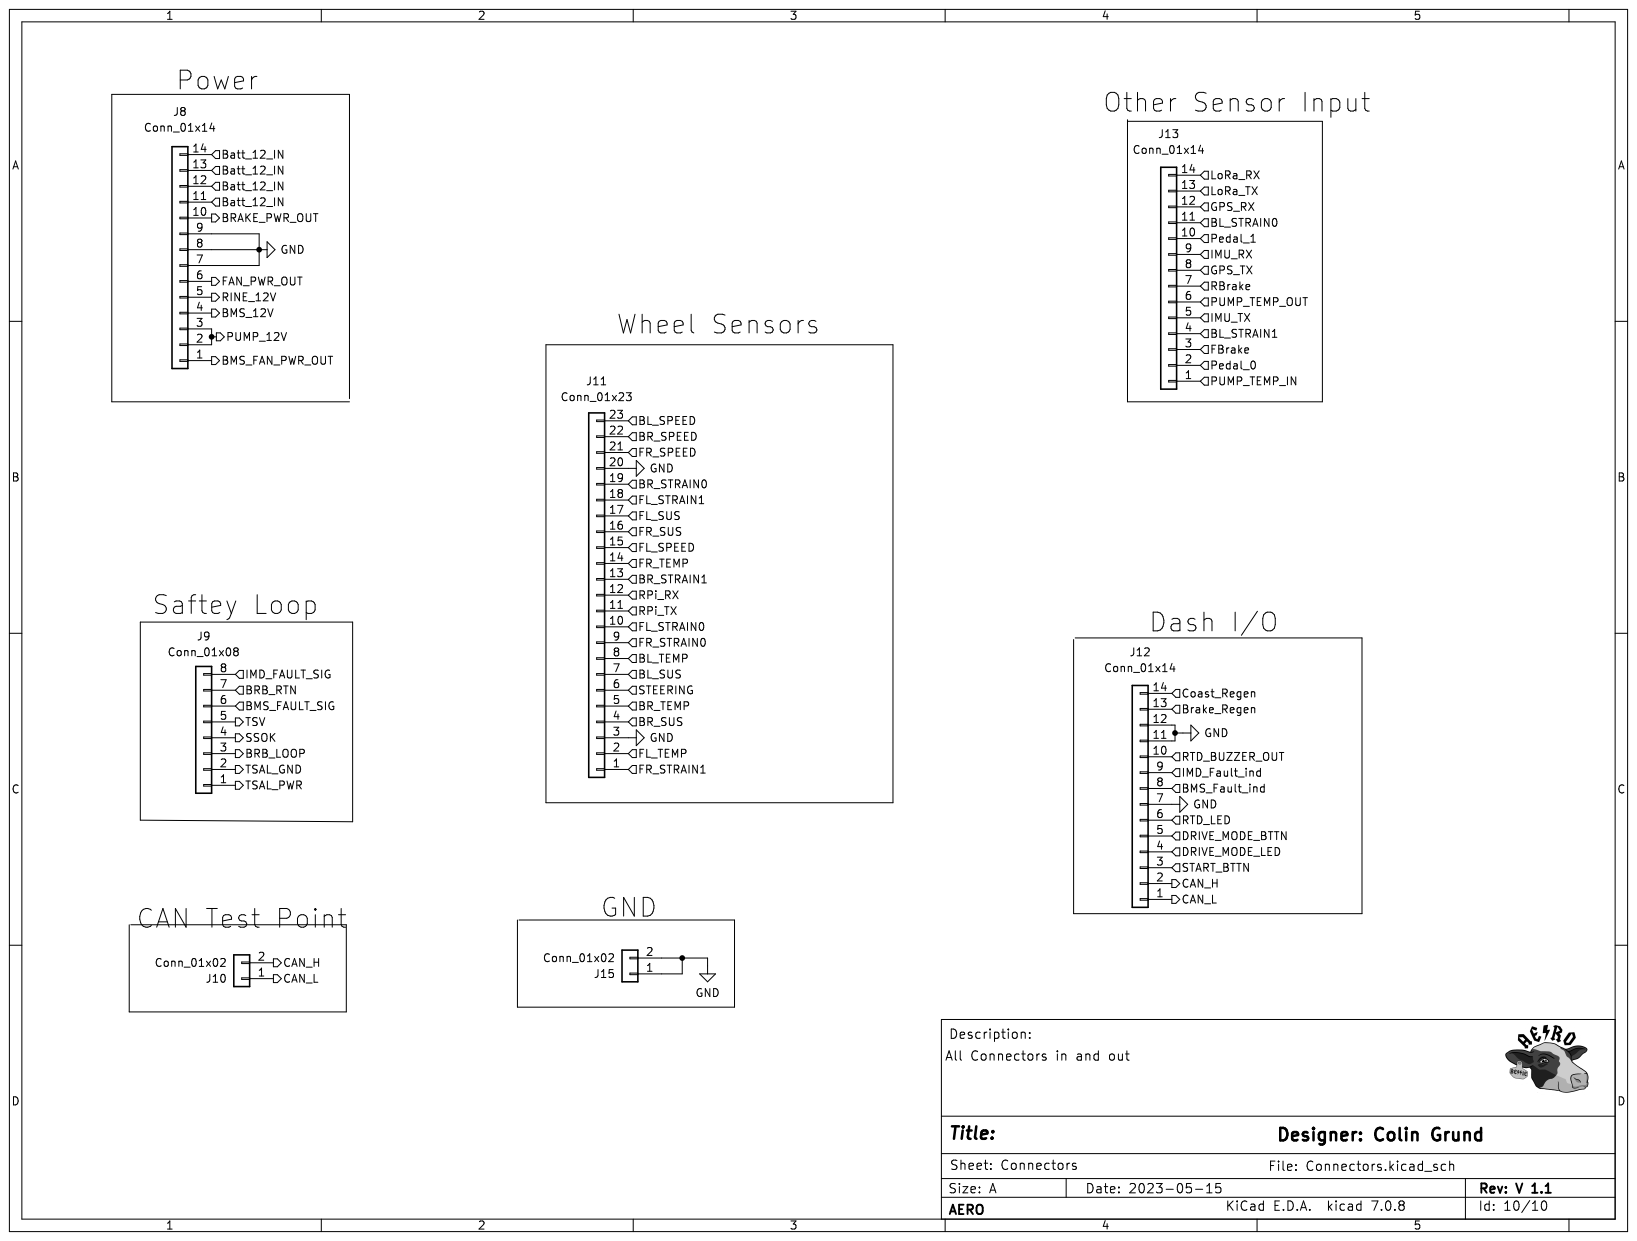
[picture p24: page 10]
