uvmaero/CleanSpeed_6.0_Board/Documentation/420Accumulator/Wire Diagram/Wiring Diagram.pdf

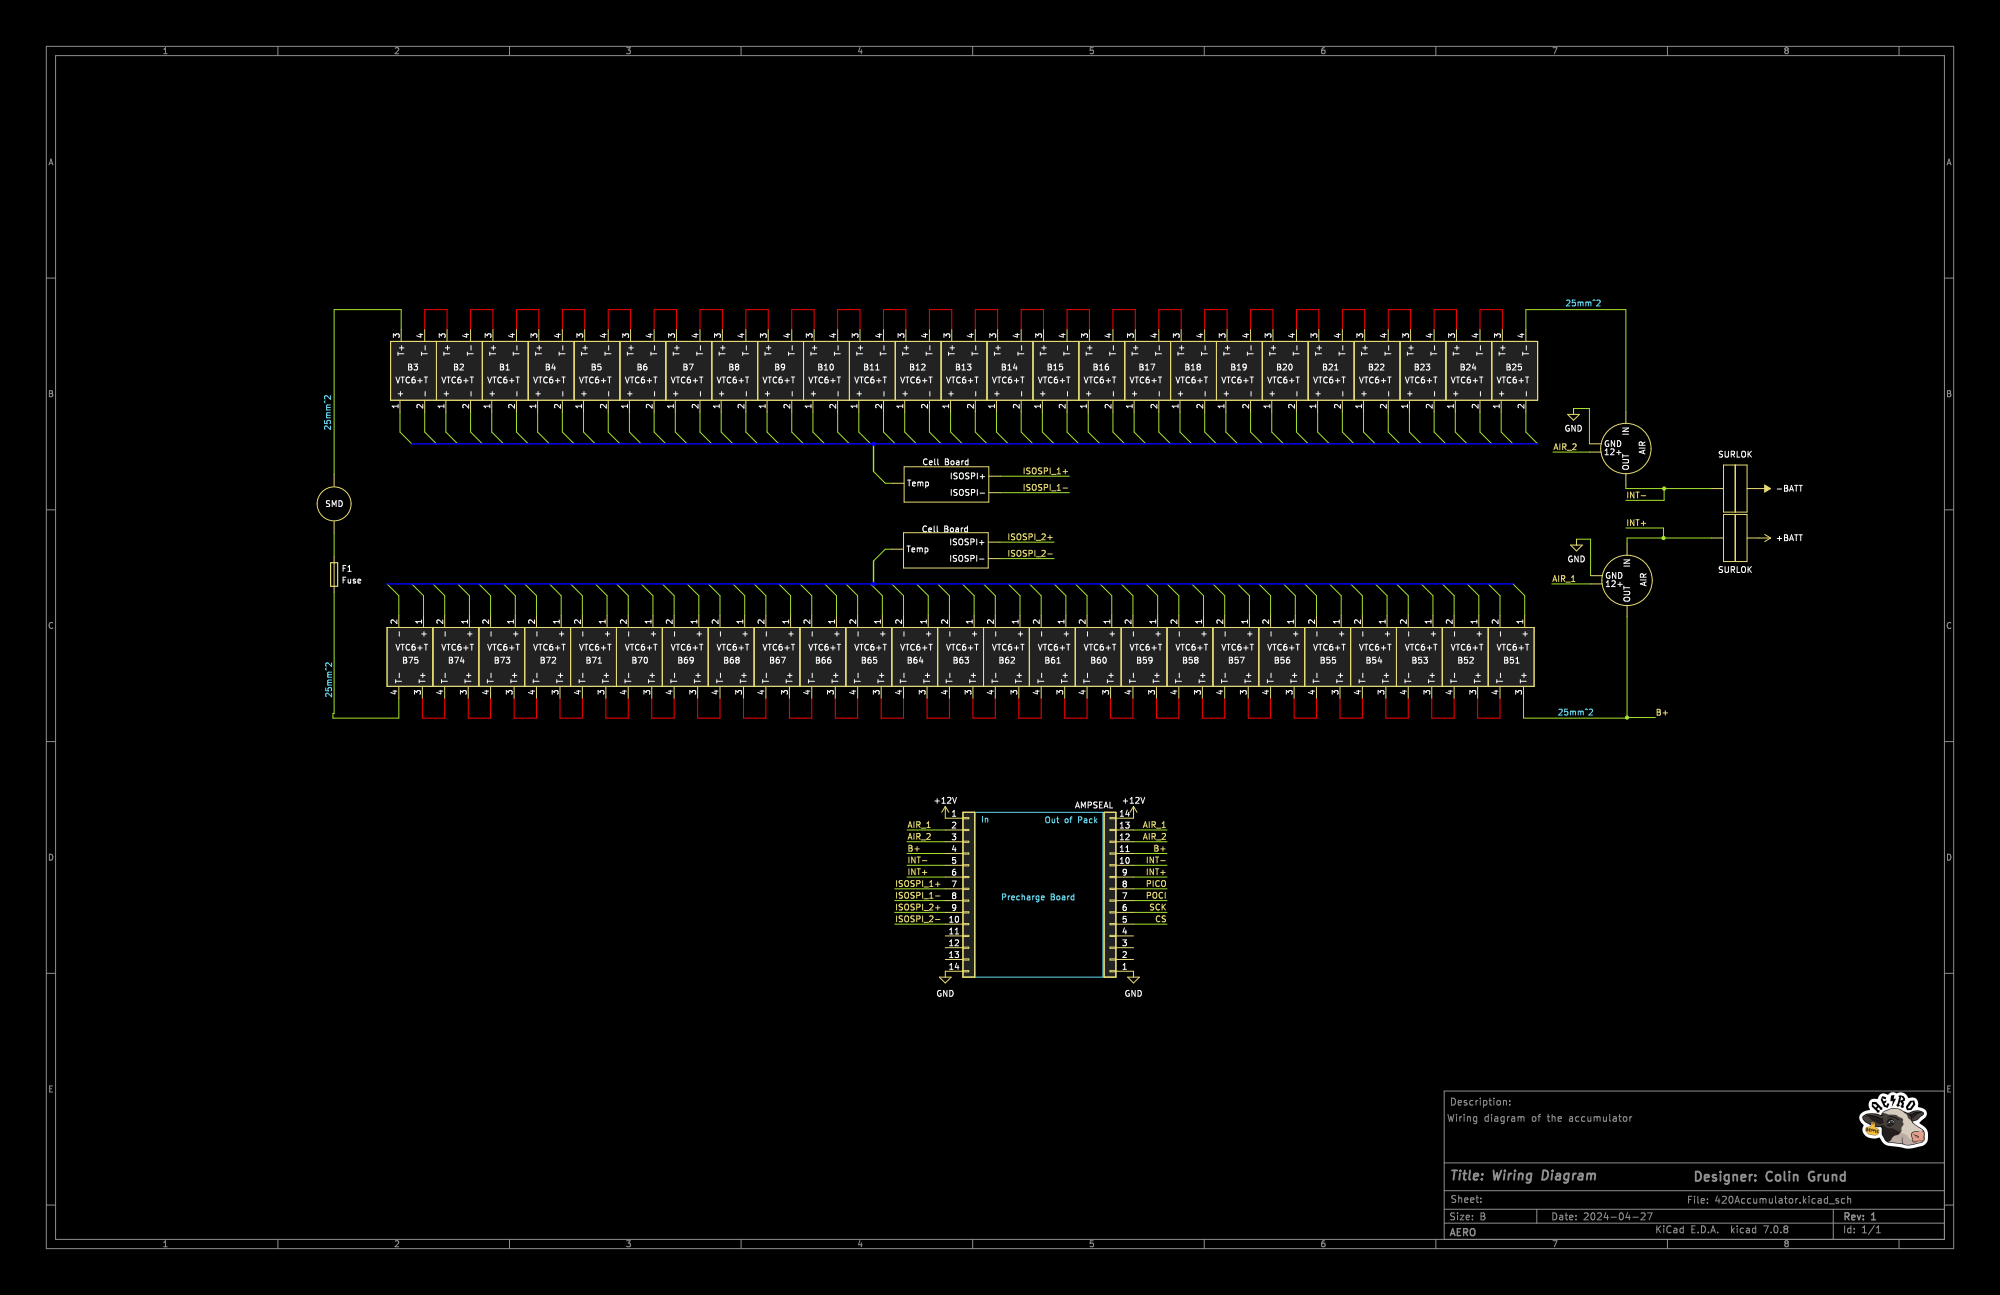
[picture p25: page 1]
