uvmaero/CleanSpeed_6.0_Board/BMS1/footy back.pdf

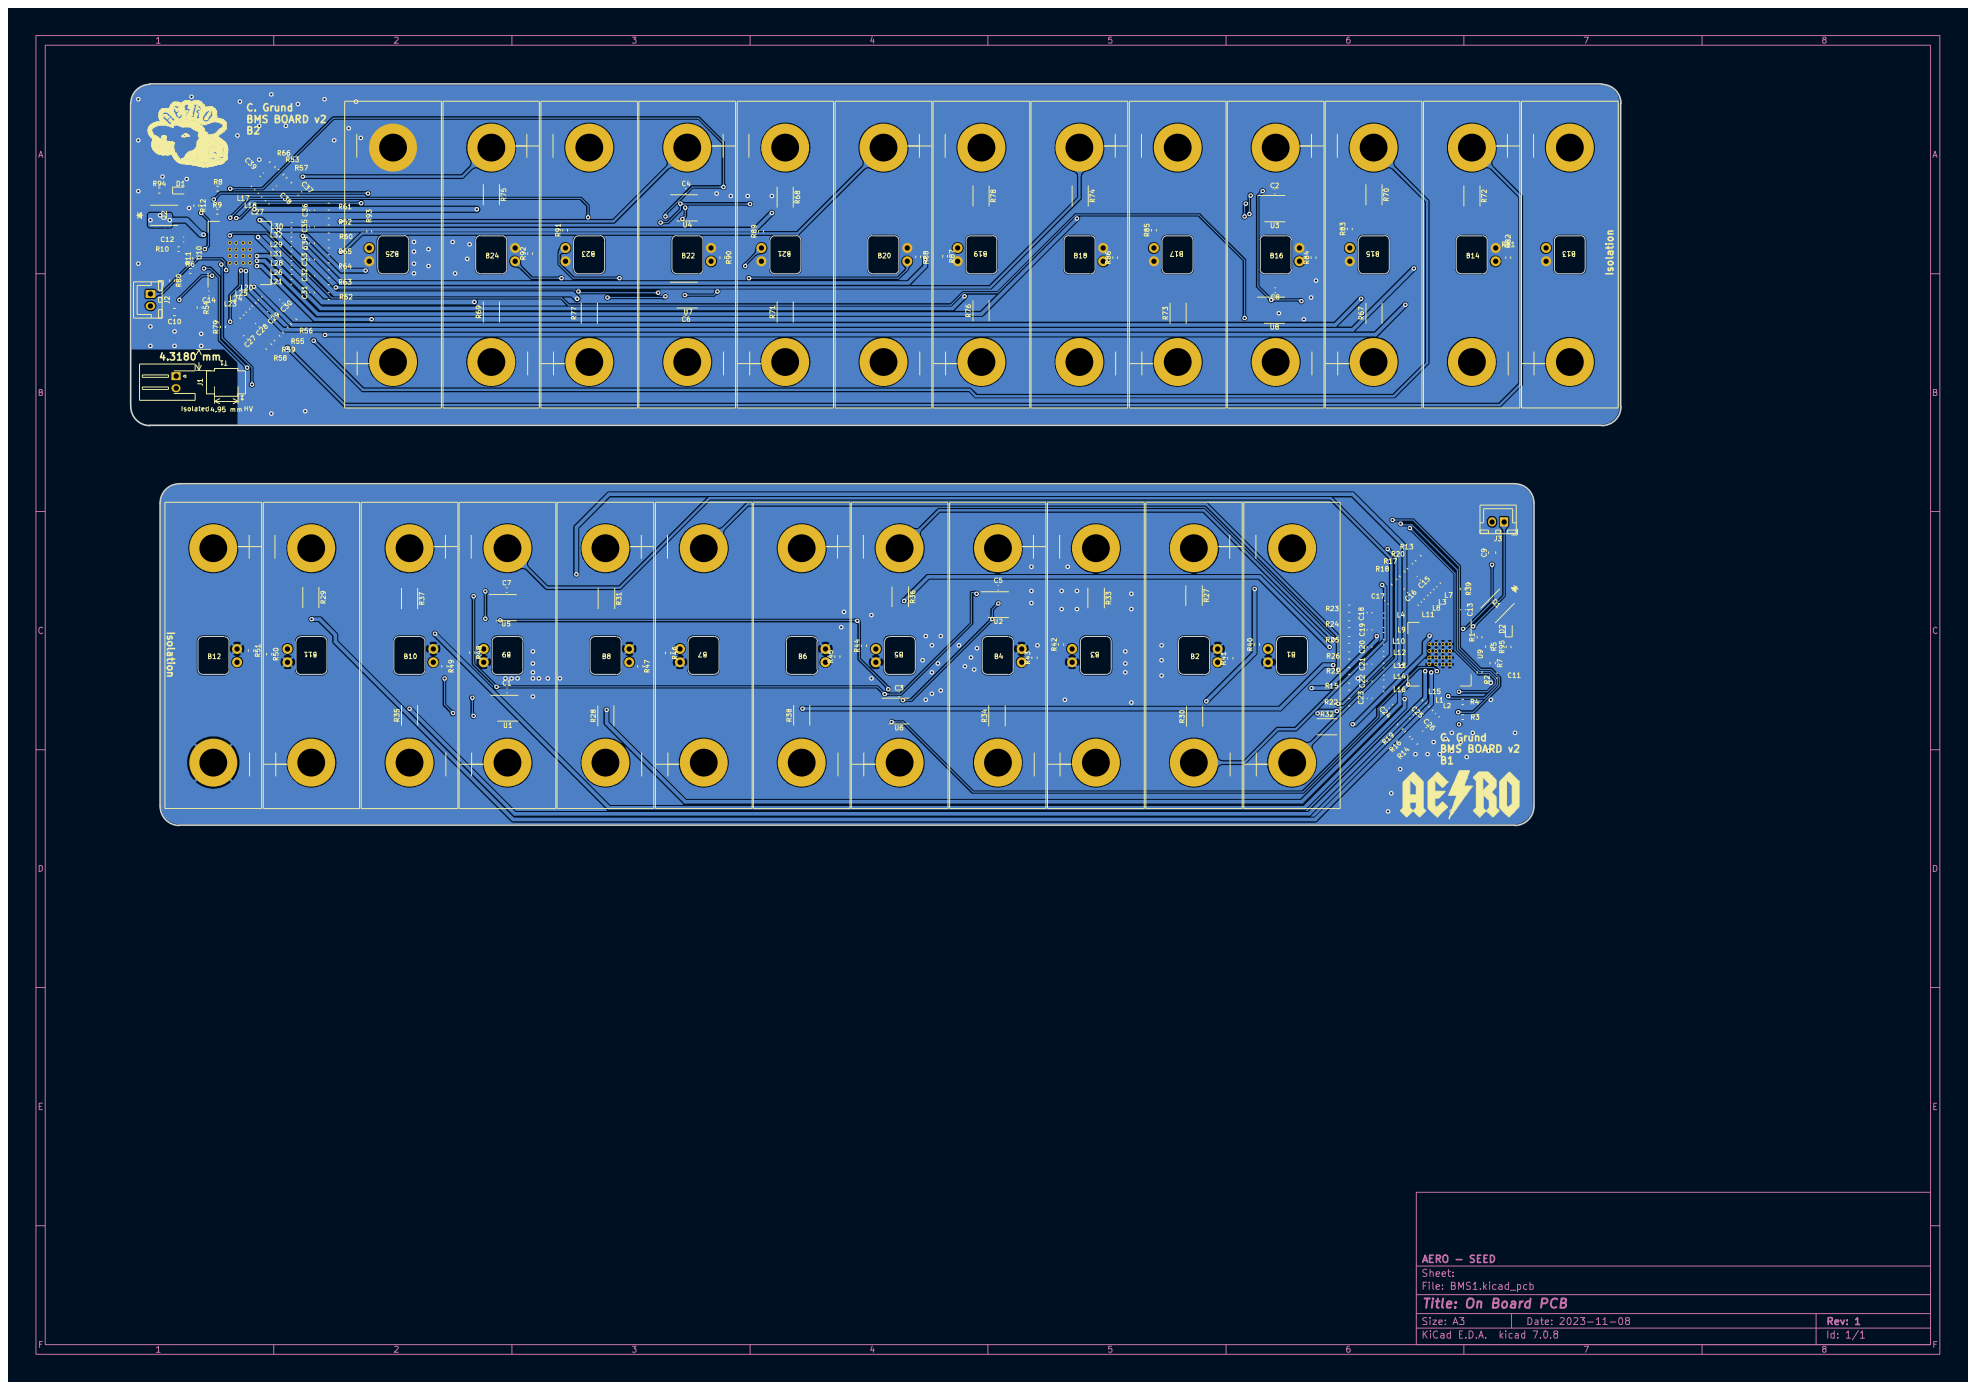
[picture p26: page 1]
