uvmaero/CleanSpeed_6.0_Board/BMS1/footy.pdf

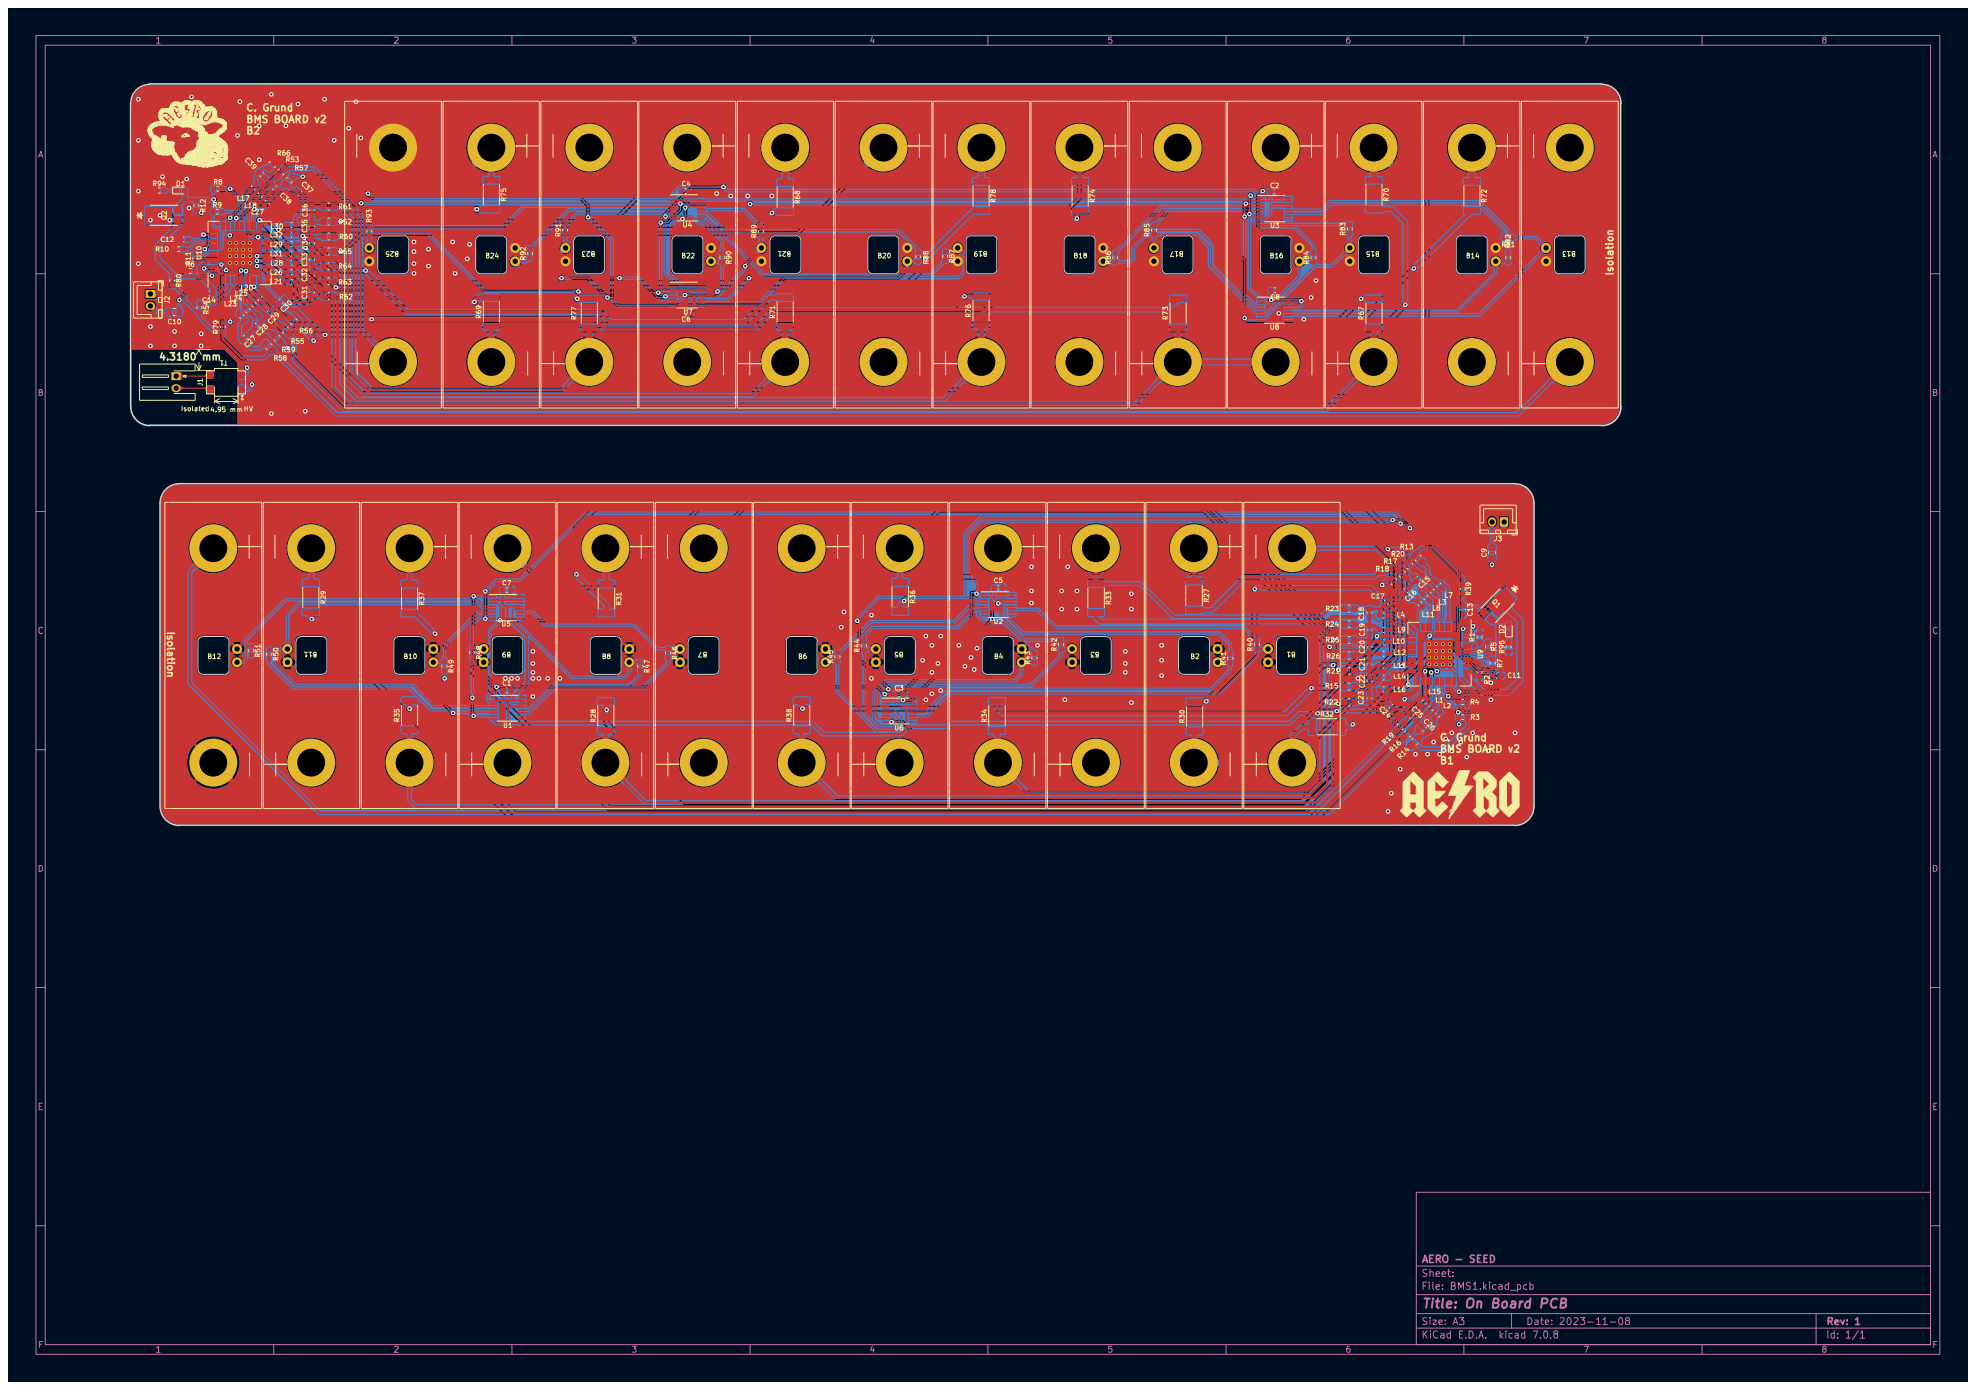
[picture p27: page 1]
