uvmaero/CleanSpeed_6.0_Board/BMS1/MainBMS/MainBMS.kicad_pcb

## KiCad design BMS1/MainBMS/MainBMS.kicad_pcb (2024-05-02)

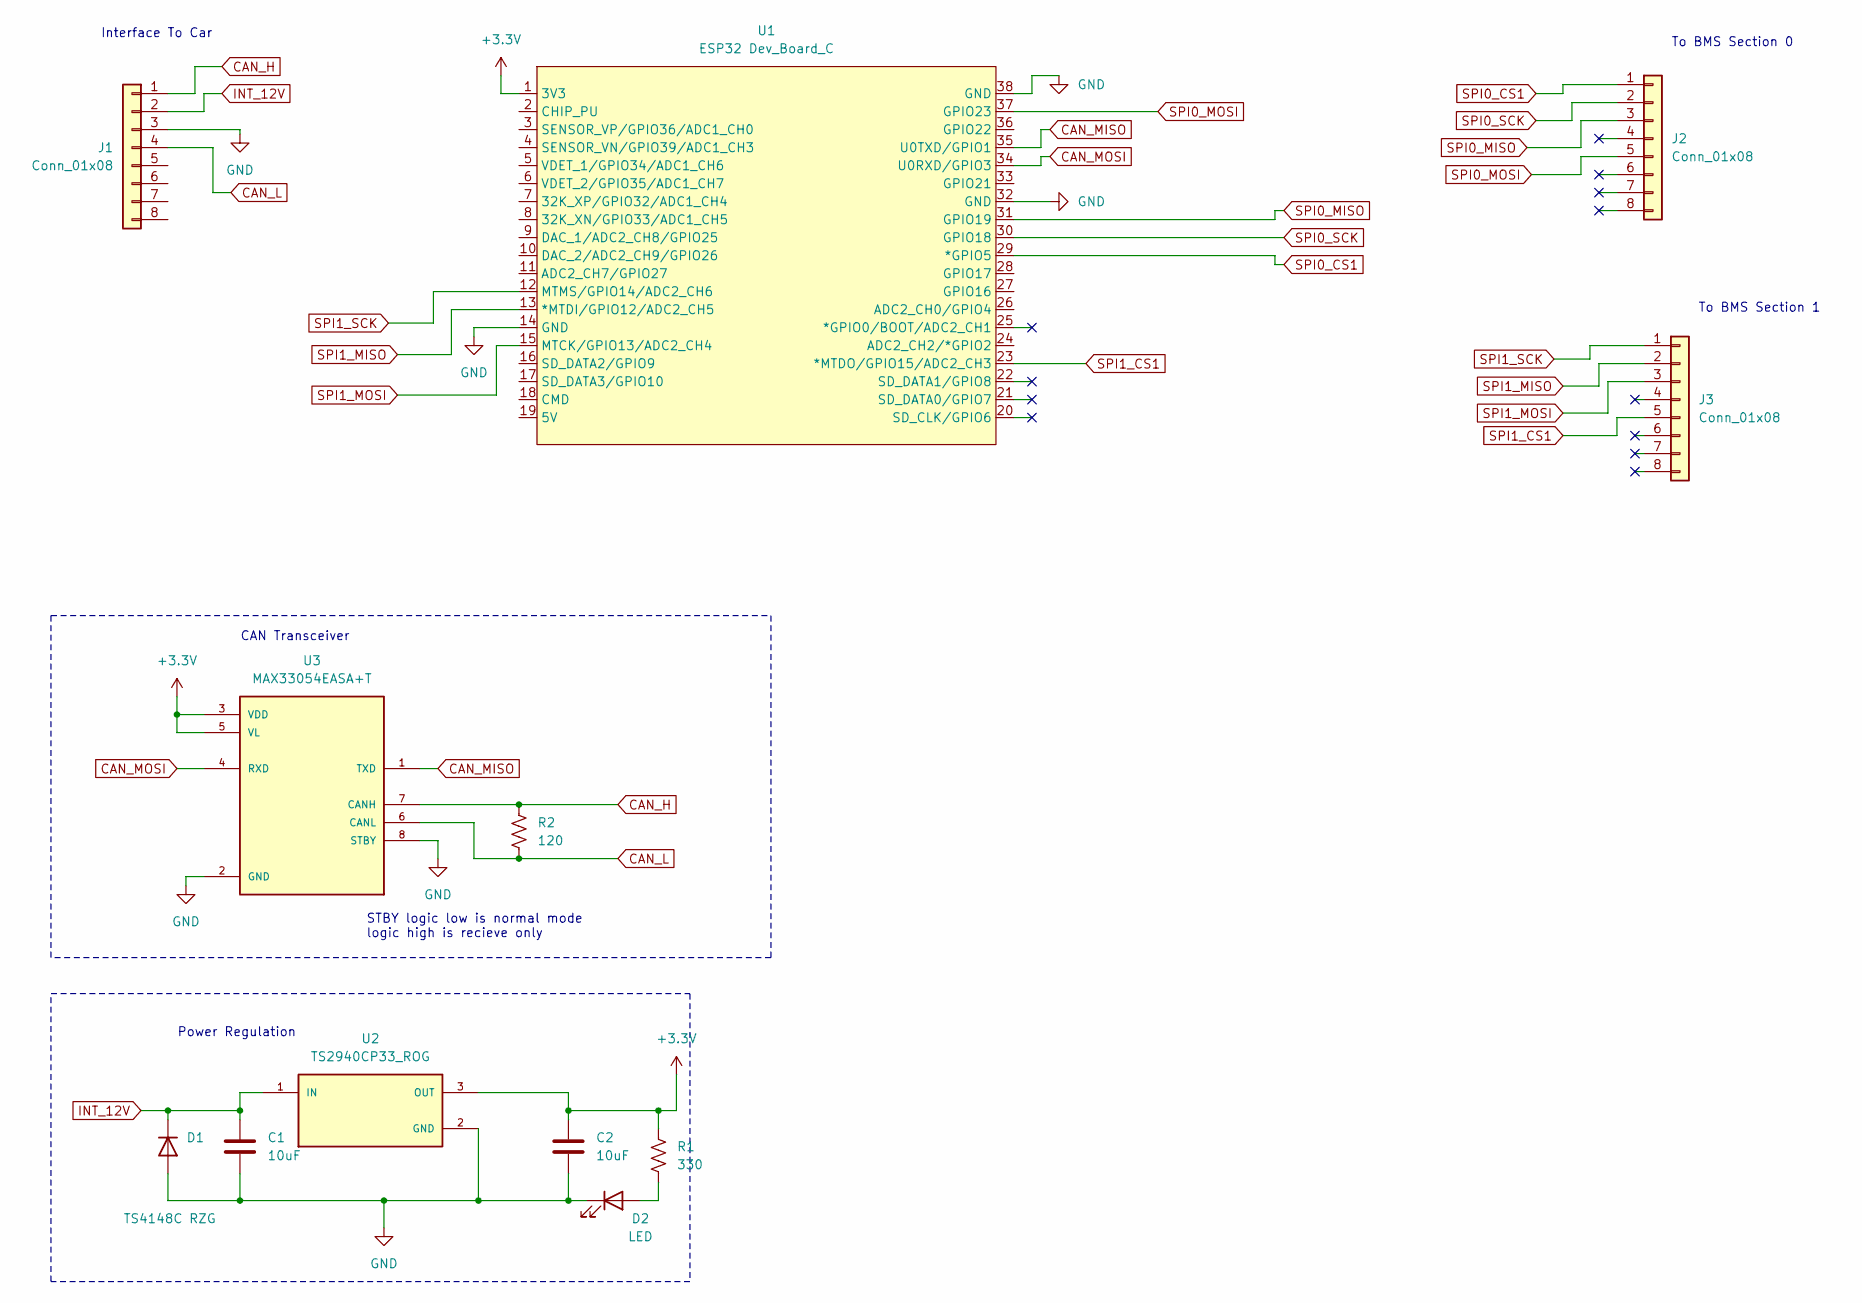
[picture p39: schematic MainBMS.kicad_sch, Main BMS Board - Thomas Brewer and Colin Grund]

Parts:
C1, C2: 10uF; C_0201_0603Metric_Pad0.64x0.40mm_HandSolder
D1: TS4148C RZG; D_0201_0603Metric_Pad0.64x0.40mm_HandSolder
D2: LED; LED_0201_0603Metric_Pad0.64x0.40mm_HandSolder
J1, J2, J3: Conn_01x08; TE_1-776280-1_8pin_Horizontal
R1: 330; R_0201_0603Metric_Pad0.64x0.40mm_HandSolder
R2: 120; R_0201_0603Metric_Pad0.64x0.40mm_HandSolder
U1: ESP32 Dev_Board_C; ESP32-DEV C
U2: TS2940CP33_ROG; VREG_TS2940CP33_ROG; PARTREV E15
U3: MAX33054EASA+T; SOIC127P600X175-8N

Connections:
+3.3V: C2.1, R1.1, U1.1 (3V3), U2.3 (OUT), U3.3 (VDD), U3.5 (VL)
CAN_H: J1.1, R2.1, U3.7 (CANH)
CAN_L: J1.4, R2.2, U3.6 (CANL)
CAN_MISO: U1.35 (U0TXD/GPIO1), U3.1 (TXD)
CAN_MOSI: U1.34 (U0RXD/GPIO3), U3.4 (RXD)
GND: C1.2, C2.2, D1.2 (A), D2.1 (K), J1.3, U1.14 (GND), U1.32 (GND), U1.38 (GND), U2.2 (GND), U3.2 (GND), U3.8 (STBY)
INT_12V: C1.1, D1.1 (K), J1.2, U2.1 (IN)
unnamed: D2.2 (A), R1.2
SPI0_CS1: J2.1, U1.29 (*GPIO5)
SPI0_MISO: J2.3, U1.31 (GPIO19)
SPI0_MOSI: J2.5, U1.37 (GPIO23)
SPI0_SCK: J2.2, U1.30 (GPIO18)
SPI1_CS1: J3.5, U1.23 (*MTDO/GPIO15/ADC2_CH3)
SPI1_MISO: J3.2, U1.13 (*MTDI/GPIO12/ADC2_CH5)
SPI1_MOSI: J3.3, U1.15 (MTCK/GPIO13/ADC2_CH4)
SPI1_SCK: J3.1, U1.12 (MTMS/GPIO14/ADC2_CH6)

Notes on the sheet:
Power Regulation
Interface To Car
CAN Transceiver
To BMS Section 0
To BMS Section 1
STBY logic low is normal mode logic high is recieve only

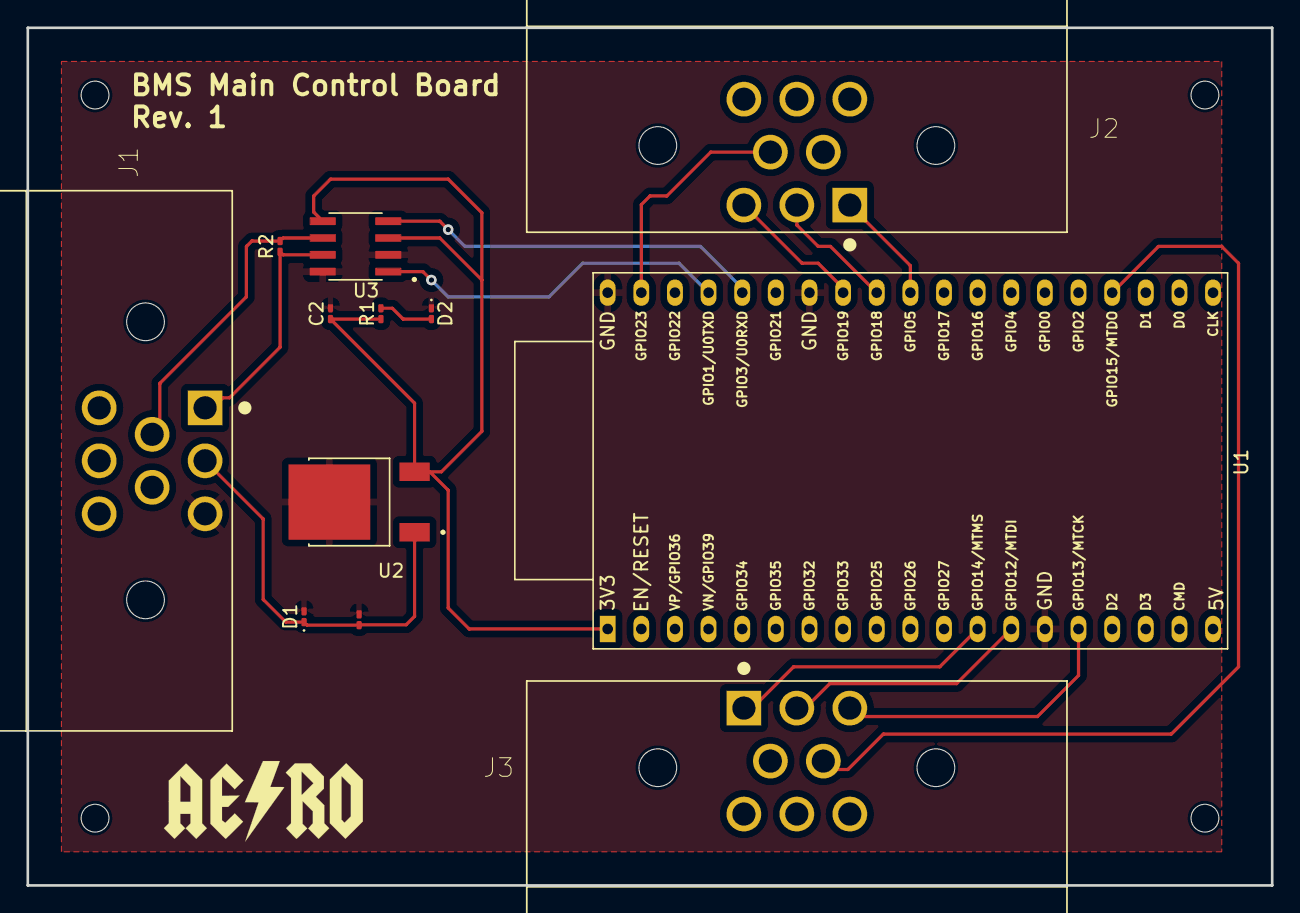
[picture p40: board MainBMS.kicad_pcb from above]

Board: 2 copper layers, 94.0 x 64.8 mm, 12 parts (0 on the bottom side), 16 nets.
