uvmaero/CleanSpeed_6.0_Board/PAC-man reed/PAC-man reed.kicad_pcb

## KiCad design PAC-man reed/PAC-man reed.kicad_pcb (2024-05-02)

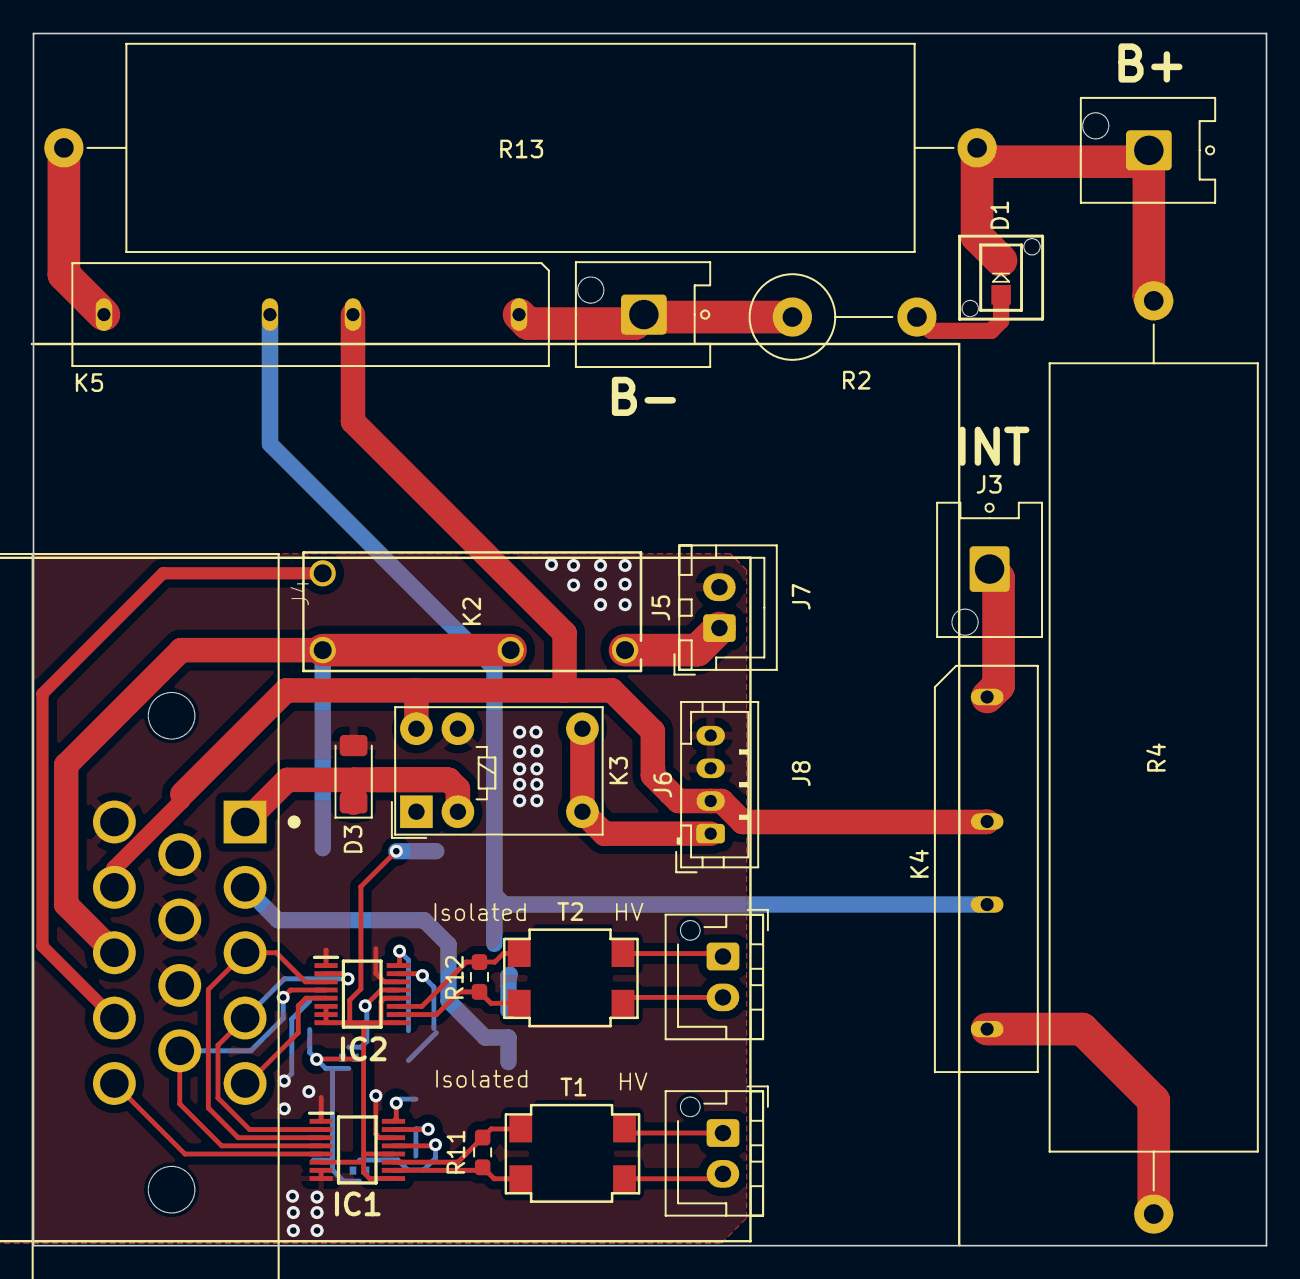
[picture p41: board PAC-man reed.kicad_pcb from above]

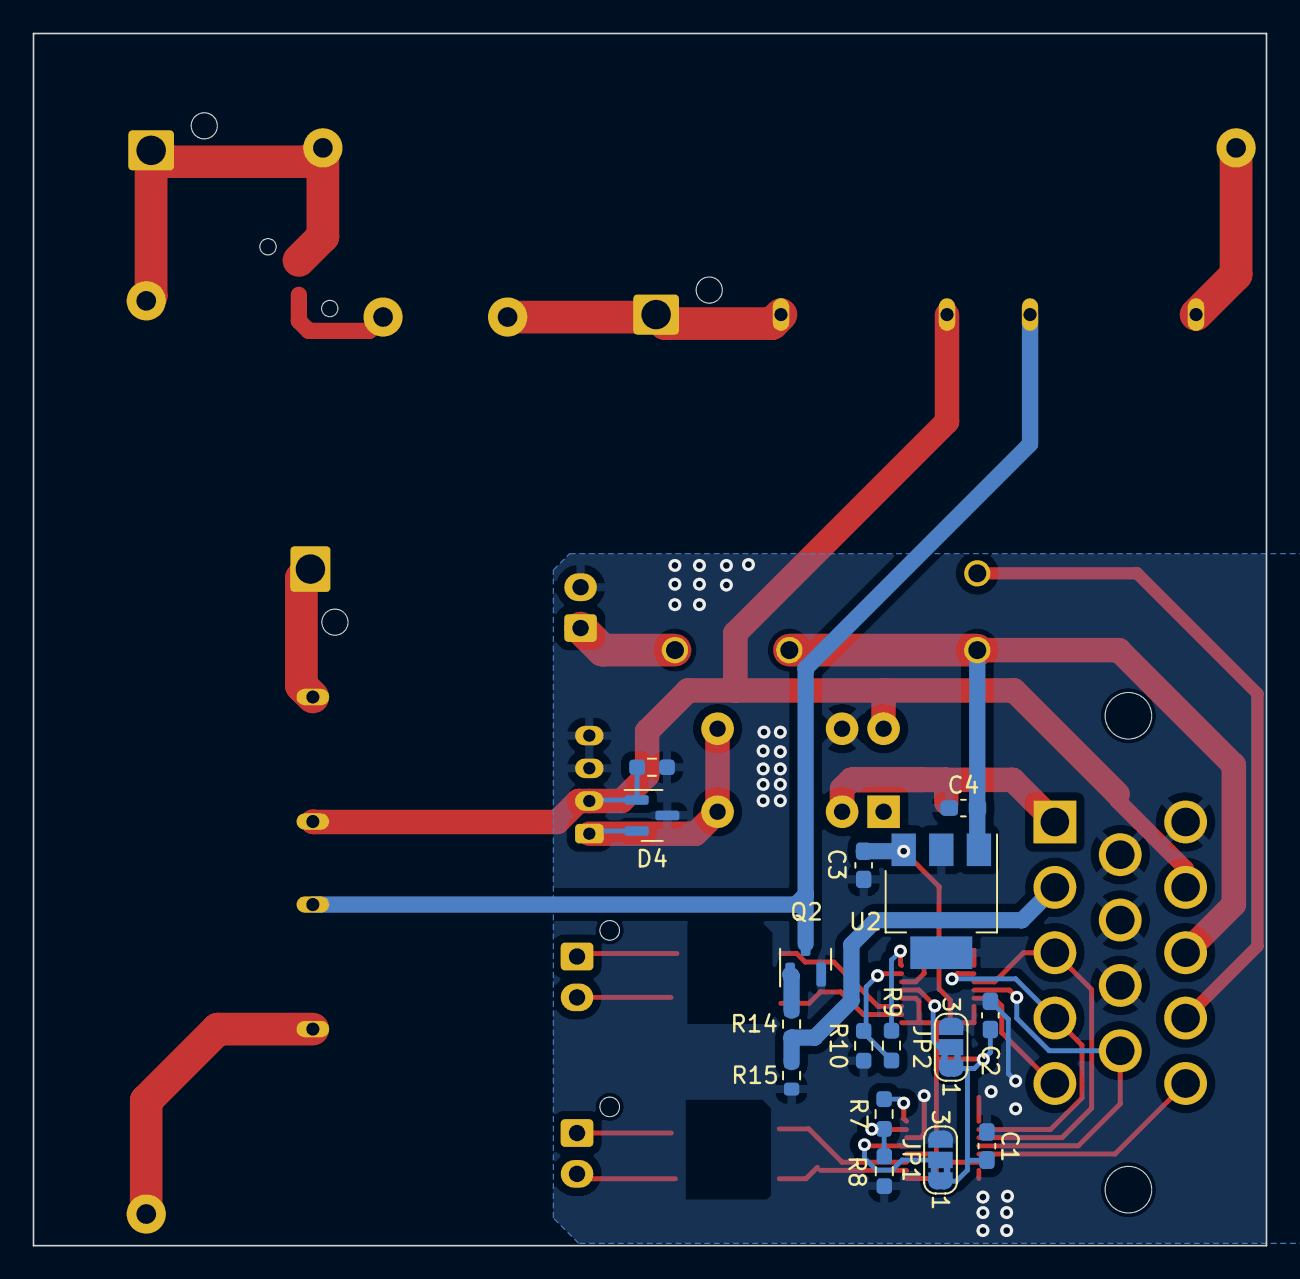
[picture p42: board PAC-man reed.kicad_pcb from below]

Board: 2 copper layers, 75.5 x 74.2 mm, 39 parts (16 on the bottom side), 36 nets.

Parts:
C1, C2: 0.01u; C_0603_1608Metric_Pad1.08x0.95mm_HandSolder
C3, C4: 10u; C_0603_1608Metric_Pad1.08x0.95mm_HandSolder
D1: LED; LPA-C011301S-x LED 0805 LIGHT PIPE SINGLE VERT SMD
D3: 1N4148; D_MiniMELF
D4: MMBZxx; SOT-23
IC1, IC2: LTC6820HMS#3ZZPBF; SOP50P490X110-16N
J1, J2, J3: Conn_01x01; Hirose_DF63M-1P-3.96DSA_1x01_P3.96mm_Vertical
J4: Conn_01x14; TE_1-776266-1_14pin_Horizontal
J5: Conn_01x02; JST_XH_B2B-XH-A_1x02_P2.50mm_Vertical
J6: JST PH; JST_PH_B4B-PH-K_1x04_P2.00mm_Vertical
J7, J8: Conn_01x02; JST_XH_B2B-XH-AM_1x02_P2.50mm_Vertical
JP1, JP2: Fast / Slow; SolderJumper-3_P1.3mm_Bridged2Bar12_RoundedPad1.0x1.5mm_Num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
K2: G5NB-1A4-E DC12; RELAY_G5NB-1A DC5_OMR
K3: G5V-1; Relay_SPDT_Omron_G5V-1
K4: 374-1408-5-ND; SHV12
K5: S1-12-BDM; S1-12
Q2: MMBT2222A; SOT-23
R2: 1.5k; R_Axial_DIN0516_L15.5mm_D5.0mm_P7.62mm_Vertical
R4: 2.5K; R_Axial_Power_L48.0mm_W12.5mm_P55.88mm
R5: 15k; R_0603_1608Metric_Pad0.98x0.95mm_HandSolder
R7, R8, R9, R10: 1k; R_0603_1608Metric_Pad0.98x0.95mm_HandSolder
R11, R12: 60; R_0603_1608Metric_Pad0.98x0.95mm_HandSolder
R13: 2.5k; R_Axial_Power_L48.0mm_W12.5mm_P55.88mm
R14: 10k; R_0603_1608Metric
R15: 2k; R_0603_1608Metric
T1, T2: ESMIT-4180_C; SOIC4_CBM4D19_SUM
U2: LT1963AxST-3.3; SOT-223-3_TabPin2

Connections:
+3.3V: C1.1, C2.1, C3.1, IC1.6 (VDDS), IC1.9 (VDD), IC1.12 (MSTR), IC2.6 (VDDS), IC2.7 (POL), IC2.8 (PHA), IC2.9 (VDD), IC2.12 (MSTR), JP1.1 (A), JP2.1 (A), U2.3 (OUT)
+12V: C4.1, J4.12, K2.1, K2.2, U2.1 (IN)
/AIR_B+: D4.2 (K), J6.1, K3.5, K3.6
/AIR_B-: D4.1 (K), J4.11, J6.2, K3.10, K4.2, K5.2, R5.2
/B+: J2.1, K5.1, R2.1
/B-: D1.1 (K), J1.1, R4.1, R13.1
/CS1: IC1.5 (~CS), J4.14
/CS2: IC2.5 (~CS), J4.5
/FAN: J4.13, K2.4
/FAN_OUT: J5.1, K2.3
/INT: J3.1, K4.1
/IsoSpi/IMA1: J7.2, T1.3
/IsoSpi/IMA2: J8.2, T2.3
/IsoSpi/IPA1: J7.1, T1.4
/IsoSpi/IPA2: J8.1, T2.4
/MAIN_CONT: D3.1 (K), J4.1, K3.2
/MISO: IC1.3 (MISO), IC2.3 (MISO), J4.3
/MOSI: IC1.2 (MOSI), IC2.2 (MOSI), J4.4
/PRECHARGE: J4.2, R14.2, R15.2
/Relay_Drive: K4.3, K5.3, Q2.3 (C)
/SCK: IC1.4 (SCK), IC2.4 (SCK), J4.9
GND: C1.2, C2.2, C3.2, C4.2, D3.2 (A), D4.3 (A), IC1.1 (EN), IC1.7 (POL), IC1.8 (PHA), IC1.14 (GND), IC2.1 (EN), IC2.14 (GND), J4.6, J4.7, J4.8, J4.10, J5.2, J6.3, J6.4, JP1.3 (B), JP2.3 (B), K3.9, Q2.2 (E), R5.1, R8.2, R10.2, R15.1, U2.2 (GND)
unnamed: D1.2 (A), R2.2
unnamed: IC1.16 (IBIAS), R7.1
unnamed: IC1.15 (ICMP), R7.2, R8.1
unnamed: IC1.10 (IM), R11.2, T1.2
unnamed: IC1.11 (IP), R11.1, T1.1
unnamed: IC1.13 (SLOW), JP1.2 (C)
unnamed: IC2.16 (IBIAS), R9.1
unnamed: IC2.15 (ICMP), R9.2, R10.1
unnamed: IC2.10 (IM), R12.2, T2.2
unnamed: IC2.11 (IP), R12.1, T2.1
unnamed: IC2.13 (SLOW), JP2.2 (C)
unnamed: K4.4, R4.2
unnamed: K5.4, R13.2
unnamed: Q2.1 (B), R14.1
