uvmaero/CleanSpeed_6.0_Board/PACman LV/PACman LV.kicad_pcb

## KiCad design PACman LV/PACman LV.kicad_pcb (2024-05-02)

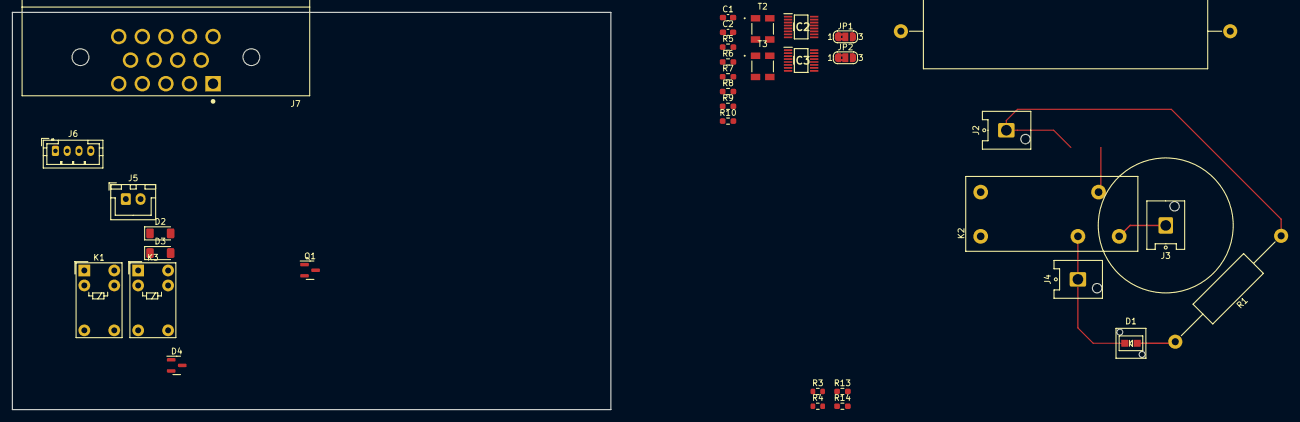
[picture p43: board PACman LV.kicad_pcb from above]

Board: 2 copper layers, 101.6 x 67.4 mm, 34 parts (0 on the bottom side), 31 nets.

Parts:
C1, C2: 0.01u; C_0603_1608Metric_Pad1.08x0.95mm_HandSolder
D1: LED; LPA-C011301S-x LED 0805 LIGHT PIPE SINGLE VERT SMD
D2, D3: 1N4148; D_MiniMELF
D4: MMBZxx; SOT-23
IC2, IC3: LTC6820HMS#3ZZPBF; SOP50P490X110-16N
J2, J3, J4: Conn_01x01; Hirose_DF63M-1P-3.96DSA_1x01_P3.96mm_Vertical
J5: Conn_01x02; JST_XH_B2B-XH-A_1x02_P2.50mm_Vertical
J6: JST PH; JST_PH_B4B-PH-K_1x04_P2.00mm_Vertical
J7: Conn_01x14; TE_1-776266-1_14pin_Horizontal
JP1, JP2: Fast / Slow; SolderJumper-3_P1.3mm_Bridged2Bar12_RoundedPad1.0x1.5mm_Num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
K1, K3: G5V-1; Relay_SPDT_Omron_G5V-1
K2: G2RL
Q1: MMBT2222A; SOT-23
R1: 1.5k; R_Axial_DIN0414_L11.9mm_D4.5mm_P25.40mm_Horizontal
R2: 5k; R_Axial_Power_L48.0mm_W12.5mm_P55.88mm
R3: 10k; R_0603_1608Metric
R4: 2k; R_0603_1608Metric
R5, R10: 60; R_0603_1608Metric_Pad0.98x0.95mm_HandSolder
R6, R7, R8, R9: 1k; R_0603_1608Metric_Pad0.98x0.95mm_HandSolder
R13, R14: 5k; R_0603_1608Metric_Pad0.98x0.95mm_HandSolder
T2, T3: CoilCraft; SRF4532-220Y

Connections:
+3.3V: C1.1, C2.1, IC2.6 (VDDS), IC2.7 (POL), IC2.8 (PHA), IC2.9 (VDD), IC2.12 (MSTR), IC3.6 (VDDS), IC3.9 (VDD), IC3.12 (MSTR), JP1.2 (C), JP2.2 (C), R13.1, R14.1
+12V: J7.12, K1.2, K1.5, K1.6
/AIR_B+: D4.2 (K), J6.2, K3.5, K3.6
/AIR_B-: D2.1 (K), D4.1 (K), J6.1, J7.9, K2.2, K3.10
/B+: J3.1, K2.10
/CS1: IC3.5 (~CS), J7.6, R13.2
/CS2: IC2.5 (~CS), J7.5, R14.2
/FAN: J7.13, K1.9
/FAN_OUT: J5.1, K1.10
/INT+: J2.1, R1.1, R2.1
/INT-: D1.1 (K), J4.1, K2.1
/MAIN_CONT: D3.1 (K), J7.8, K3.2
/MISO: IC2.3 (MISO), IC3.3 (MISO), J7.10
/MOSI: IC2.2 (MOSI), IC3.2 (MOSI), J7.7
/PRECHARGE: J7.11, R3.2, R4.2
/SCK: IC2.4 (SCK), IC3.4 (SCK), J7.4
GND: C1.2, C2.2, D3.2 (A), D4.3 (A), IC2.1 (EN), IC2.14 (GND), IC3.1 (EN), IC3.7 (POL), IC3.8 (PHA), IC3.14 (GND), J5.2, J6.3, J6.4, J7.14, JP1.3 (B), JP2.3 (B), K3.9, Q1.2 (E), R4.1, R7.2, R9.2
unnamed: D1.2 (A), R1.2
unnamed: D2.2 (A), K2.9, Q1.3 (C)
unnamed: IC2.16 (IBIAS), R6.1
unnamed: IC2.15 (ICMP), R6.2, R7.1
unnamed: IC2.10 (IM), R5.2, T2.2 (AB)
unnamed: IC2.11 (IP), R5.1, T2.1 (AA)
unnamed: IC2.13 (SLOW), JP1.1 (A)
unnamed: IC3.16 (IBIAS), R8.1
unnamed: IC3.15 (ICMP), R8.2, R9.1
unnamed: IC3.10 (IM), R10.2, T3.2 (AB)
unnamed: IC3.11 (IP), R10.1, T3.1 (AA)
unnamed: IC3.13 (SLOW), JP2.1 (A)
unnamed: K2.5, R2.2
unnamed: Q1.1 (B), R3.1
