uvmaero/CleanSpeed_6.0_Board/(commit log)

2023-05-15 DADDY BOARD
    [Big Daddy.kicad_pcb, Big Daddy.kicad_sch, Connectors.kicad_sch, Cooling.kicad_sch, DCDC.kicad_sch, Fusing.kicad_sch, High Voltage.kicad_sch, Latching.kicad_sch]
2024-01-09 Just need last circuit and traced but 90% done
    Pushing big daddy almost everything is where it needs to be might do net classes to make traces easier but timing. The schematic is 90% done trying to make a better charging circuit from vicor so no fires. will be done after silly week!
    [Accumulator_Container.kicad_sch, Big Daddy.kicad_pcb, Big Daddy.kicad_sch, Connectors.kicad_sch, Cooling.kicad_sch, DCDC.kicad_sch, Demo_led.kicad_pcb, Demo_led.kicad_sch]
2024-01-09 edge cuts
    [Big Daddy.kicad_pcb]
2024-01-11 Schematic DONE
    [Big Daddy.kicad_pcb, Fusing.kicad_sch]
2024-02-07 so cloes
    [Big Daddy.kicad_pcb, Big Daddy.kicad_sch, Connectors.kicad_sch, DCDC.kicad_sch, Fusing.kicad_sch, Micro.kicad_sch, TSAL.kicad_sch]
2024-02-07 REVIEW TIME
    [Big Daddy.kicad_pcb, Connectors.kicad_sch]
2024-02-26 board thats here
    [Big Daddy.kicad_pcb, IsoSPI.kicad_sch, PACman LV.kicad_sch, connectors.xlsx]
2024-05-02 post comp
    [420Accumulator.kicad_sch, Advanced Kicad example.kicad_pcb, Advanced Kicad example.kicad_sch, Big Daddy.kicad_pcb, Big Daddy.kicad_sch, Cells.kicad_sch, Fusing.kicad_sch, IsoSPI.kicad_sch]
2024-05-02 BMS added
    [BMS1-B_Cu.gbr, BMS1-B_Mask.gbr, BMS1-B_Paste.gbr, BMS1-B_Silkscreen.gbr, BMS1-Edge_Cuts.gbr, BMS1-F_Cu.gbr, BMS1-F_Mask.gbr, BMS1-F_Paste.gbr]
2025-04-10 Updated BOM
    [Big Daddy.kicad_pcb, Big Daddy.kicad_sch, Connectors.kicad_sch, Cooling.kicad_sch, DCDC.kicad_sch, Fusing.kicad_sch, High Voltage.kicad_sch, Latching.kicad_sch]
