uvmaero/CleanSpeed_6.0_Board/(notices)

Notices in the files:
parts and their libraries:
Copyright 2016 Accelerated Designs. All rights reserved.
